nussinussi/Projekt6Thesis/Fachbericht/subsections/Server.tex

\subsection{Server}\label{subsec: Server}
Als Server für die Openhab Software wird ein Raspberry Pi der 4. Generation mit 2 GB RAM eingesetzt, die Installation und Inbetriebnahme wird im Benutzerhandbuch beschrieben. In Openhab wird ebenfalls ein eigener MQTT-Broker eingebunden. Damit diese Broker von jedem Gerät im Lokalen Netzwerk erreicht werden kann, wird dem Server eine Statische IP-Adresse vergeben.\\
\\
Um den Sprachassistent einzubinden,ist ein weiterer Server mit der Home Assistant Software in das System integriert worden. Dieser Server wurde auf ein Rasperrypi 4. Generation 2 GB RAM installiert. Der Grund warum nicht beide Server auf dem selben Raspberrypi installiert wurden, ist einerseits, das System ist physikalisch Modular aufgebaut der Sprach Assistent kann als separates Thing (Gerät) betrachtet werden. Andererseits, wenn sich beide Server auf dem Selben Gerät befinden wäre die MQTT-Kommunikation sinnlos.  

\begin{figure}[H]
	\centering
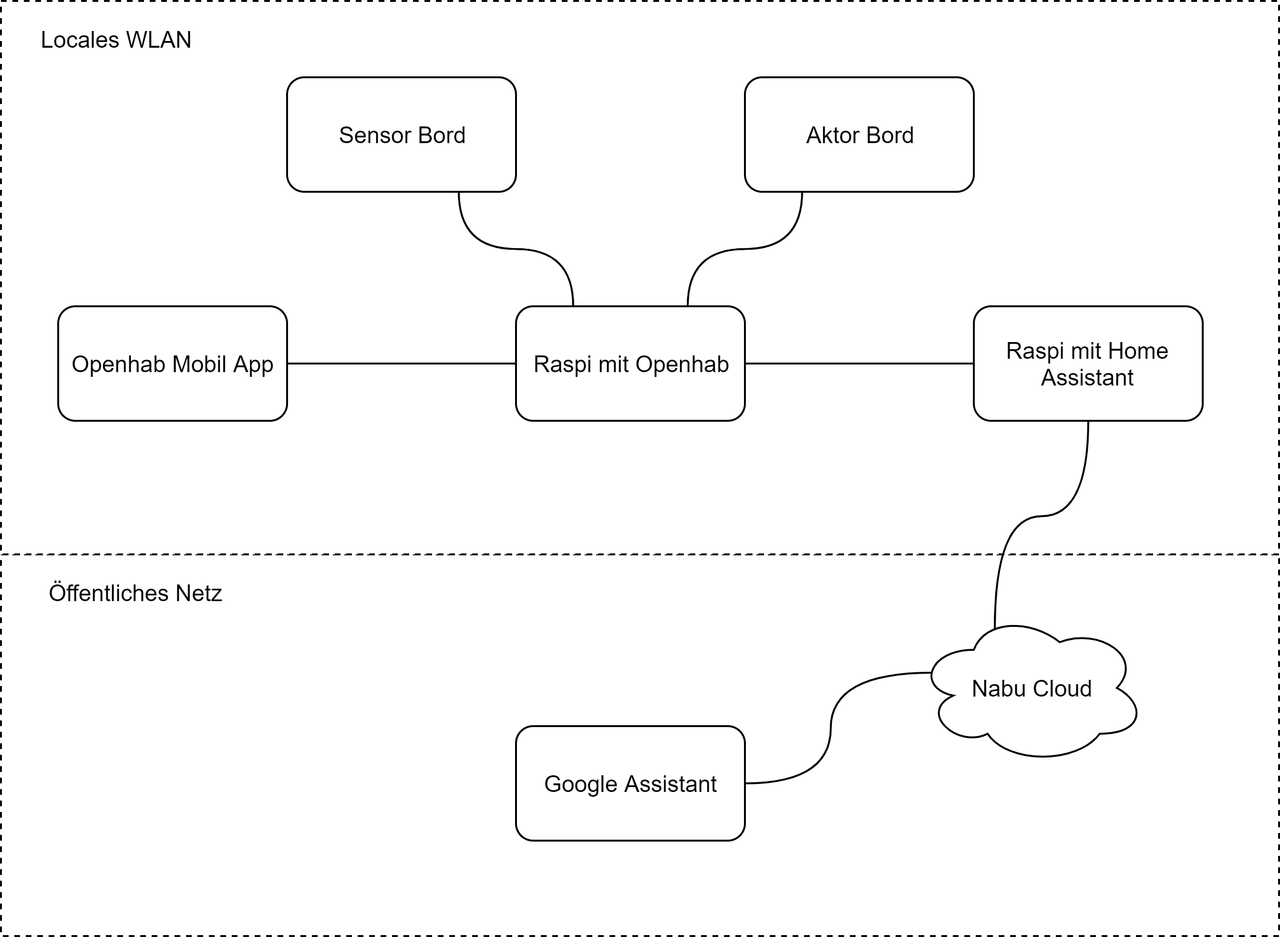
[picture p45: Fachbericht/graphics/Systemubersicht.png]
	
	\caption{Systemübersicht}
	\label{pic: Systemübersicht}
\end{figure}   

In der Abbildung \ref{pic: Systemübersicht} kann erkannt werden, dass sich beide Server im selben Lokalen Netzwerk befinden. Die Kommunikation zwischen den beiden Server findet über MQTT statt, es besteht die Möglichkeit den Openhab-Server zu umgehen und eine direkte Kommunikation vom Home Assistant zu dem Sensor- oder zum Aktorbord zu realisieren. In diesem Fall müssen aber die Regeln bei welchem Aktion, welche Schalthandlung ausgelösst wird, in den entsprechenden Mikrocontroller programmiert werden.

\subsection{Sprachassistent}
Der Home Assistant wird als Brücke für den Google Assistant installiert. Mit der Home Assistant Cloud wird eine Verbindung zum Google Assistant hergestellt. Der Grund, warum die Verbindung so aufgebaut wird, liegt darin, dass die dynamische DNS Adresse, SSL-Zertifikate und das öffnen von Ports auf dem Router so umgangen werden. Leider ist die Cloud nach einer Testphase kostenpflichtig. Wird die Lösung ohne Cloud bevorzugt, kann nach Anleitung \cite{assistant_google_nodate} gearbeitet werden. Die Cloud ist im /config/configuration.yaml file schon vorinstalliert. Im Webinterface vom Home Assistant kann in den Einstellungen ein Benutzerkonto angelegt werden und schon ist die Cloud aktiv. Das hinzufügen von Schalter um MQTT-Befehle zu generieren wird im Benutzerhandbuch im Anhang beschrieben. Die Installation auf dem Google-Nest (Monitor von Google) wird mit einem Smartphone durchgeführt. Mittels Google Home App kann das Gerät 'Home Assistant' hinzugefügt werden.
\begin{figure}[H]
	\centering
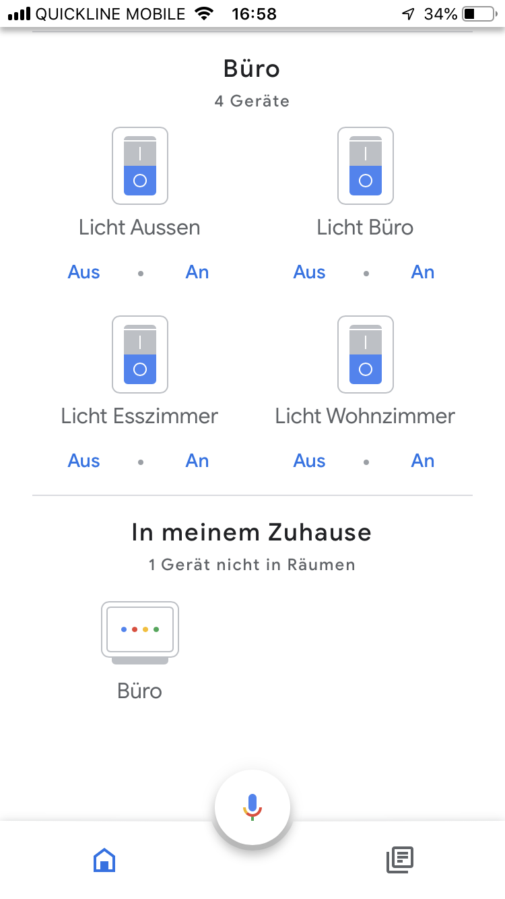
[picture p46: Fachbericht/graphics/GoogleAssistant.png]
	
	\caption{Google Assistant Mobile-App}
	\label{pic: GoogleAssistant}
\end{figure}   
In der Abbildung \ref{pic: GoogleAssistant} können die Schalter, welche Home Assistant definiert wurden erkannt werden. Sie können mit Sprachbefehl geschalten werden, falls die Schalter-Bezeichnung und der Zustand genannt wird, wie beispielsweise "Licht-Büro-ein". Die verschiedenen Geräte können, nebst dem Sprachbefehl in dieser Ansicht, mit einem Touch-Befehl geschallten werden.
