nussinussi/Projekt6Thesis/Fachbericht/sections/Software.tex

\section{Software}
In diesem Kapitel wird der Softwarebereich beschrieben. Es wird erklärt, wie die Frameworks der Mikrocontroller, welche auf den Sensor und Aktorbausteinen laufen, evaluiert wurden. Zusätzlich wird die Realisierung des Frameworks für den inhouse Server und die Kommunikation mit dem MQTT Protokoll aufgezeigt.

\input{subsections/Mikrocontroller}
\input{subsections/Framework}
\input{subsections/Kommunikation}
\input{subsections/Server}
