nussinussi/Projekt6Thesis/Fachbericht/sections/Ehrlichkeitserklaerung.tex

\section{Ehrlichkeitserklärung}

Hiermit erklären wir, dass die vorliegende Arbeit selbständig von uns, ohne Hilfe Dritter und nur unter Benutzung der angegebenen Quellen verfasst wurde.\\
\\
\\
\\
\\
\\
\\

	\begin{tabular}{l l}
	\textbf{Projekt Team} \\
	\\
	\\
	Lukas Meienberger und Gabriel Nussbaumer \\ 
	\\
	\\
		\rule{44mm}{.15mm} & \hspace{1mm} \rule{70mm}{.15mm} \\
	Ort, Datum & \hspace{1mm} Unterschriften \\
	
\end{tabular}\\
