nussinussi/Projekt6Thesis/Fachbericht/sections/Hardware.tex

\section{Hardware}
 
\input{subsections/Sensorbaustein}
 \newpage
\input{subsections/Aktorbaustein}
