nussinussi/Projekt6Thesis/Poster/Template_Poster_Thesis_V2019_EIT.pptx

Ausstellungs-Nr. Enn

Studiengang / Semester: Elektro – und Informationstechnik FS19
Diplomandin: Petra Muster
Auftraggeber: Experimental Sample AG
Experte: Paul Müller, dipl. Ing. ETH
Dozent : Prof. Dr. Emil Dreher, emil.dreher@fhnw.ch
