nussinussi/Projekt6Thesis/Benutzerhanbuch/Latex Benutzerhanbuch/Benutzerhandbuch/versions/1.0_Regelauslegung.pdf

# Geberloser drehzahlvariabler Drehfehlmaschinen-Antrieb

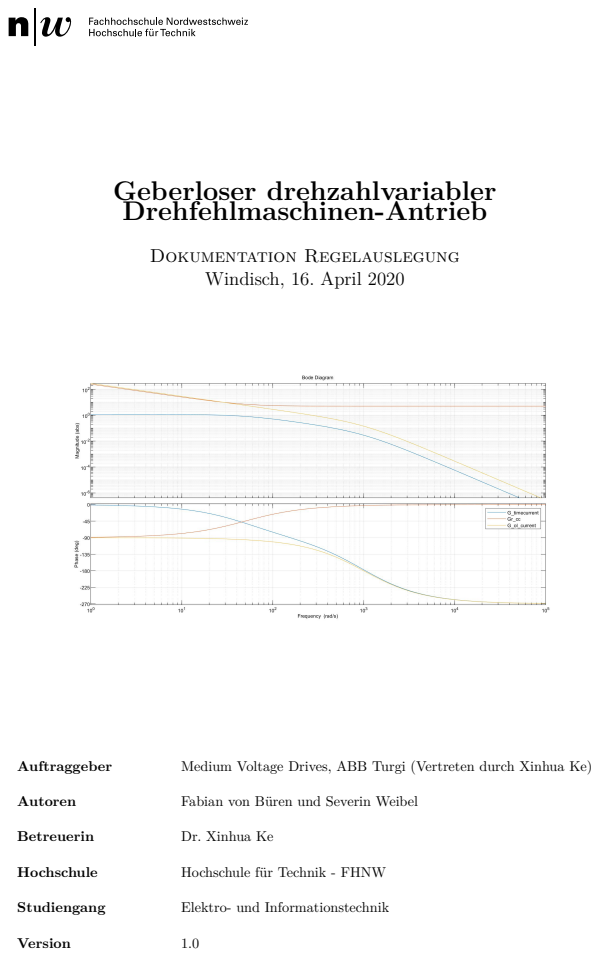
[picture p79: page 1]
Dokumentation Regelauslegung Windisch, 16. April 2020; Auftraggeber; Medium Voltage Drives, ABB Turgi (Vertreten durch Xinhua Ke); Autoren; Fabian von Büren und Severin Weibel; Betreuerin; Dr. Xinhua Ke; Hochschule; Hochschule für Technik - FHNW; Studiengang; Elektro- und Informationstechnik; Version

INHALTSVERZEICHNIS | I

### Inhaltsverzeichnis

1 Dokumentation der Regelauslegung | 1
2 Simulationsresultat | 11
3 Offene Pendenzen | 12
4 Literatur | 14
A Messungen Zeitverzögerung Modulator | 15

1

### 1 Dokumentation der Regelauslegung

Durchgeführt von: Fabian von Büren & Severin Weibel

Datum: 16. April 2020

Diese Dokumentation beschreibt das Vorgehen der Regelauslegung. Die rotorflussorientierte Drehzahlregelung umfasst insgesamt drei Regelkreise. Bei jedem Regelkreis wird ein PI-Regler verwendet. Das Ziel ist die Bestimmung der Proportionalverstärkung (kp) sowie die Integralverstärkung (ki). Begonnen wird mit dem unterlagertem Stromregelkreis. Die mathematische Beschreibung der ASM basiert auf dem Skript „Geregelte Antriebe“ [1]. Es wird ein linearer Regler ausgelegt.

### 1.1 Maschinenparameter

Folgende Maschine wird verwendet:

Hersteller | Siemens
Maschinentyp | Käfigläufer ASM
Maschinennummer | 1LE1001-1CB03-4AA4
Nennspannung UN (50Hz, 60Hz) | ∆400V, ∆460V
Nennstrom IN (50Hz, 60Hz) | 11.3A, 9.9A
Nennleistung PN | 5.5kW
cosϕ | 0.8
Nenndrehzahl ωn(50Hz) | 1465U/min

Tabelle 1.1: Nenndaten für die auszumessende ASM-Maschine

Folgende Maschinenparameter werden verwendet (ASM im Labor ausgemessen):

Rotorwiderstand RS | 2.6/3Ω
Hauptinduktivität Lh | 359.9/3mH
Streuinduktivität Stator Lσ,S | 54.23/2/3mH
Streuinduktivität Rotor Lσ,R | 54.23/2/3mH
Statorwiderstand RR | 2.6/3Ω

Tabelle 1.2: Ergebnisse für die untersuchte ASM-Maschine (Faktor 3 aufgrund Stern-Dreieck-Umwandlung)

Folgende Variablen werden zur vereinfachten Darstellung verwendet:

1.2 Stromregelkreis (unterlagert) | 2
LS = Lσ,S + Lh | (1.1a)
LR = Lσ,R + Lh | (1.1b)

L

2
σ = LS · LR − Lh
2 | (1.1c)

### 1.2 Stromregelkreis (unterlagert)

In der Abbildung 1.1 ist das Blockschaltbild mit den berücksichtigten Elementen dargestellt. Die Bezeichnungen der Übertragungsfunktionen stimmen mit dem Matlab-File überein. Zur Bestimmung der Regelparameter muss die zu regelnde Strecke identifiziert werden.

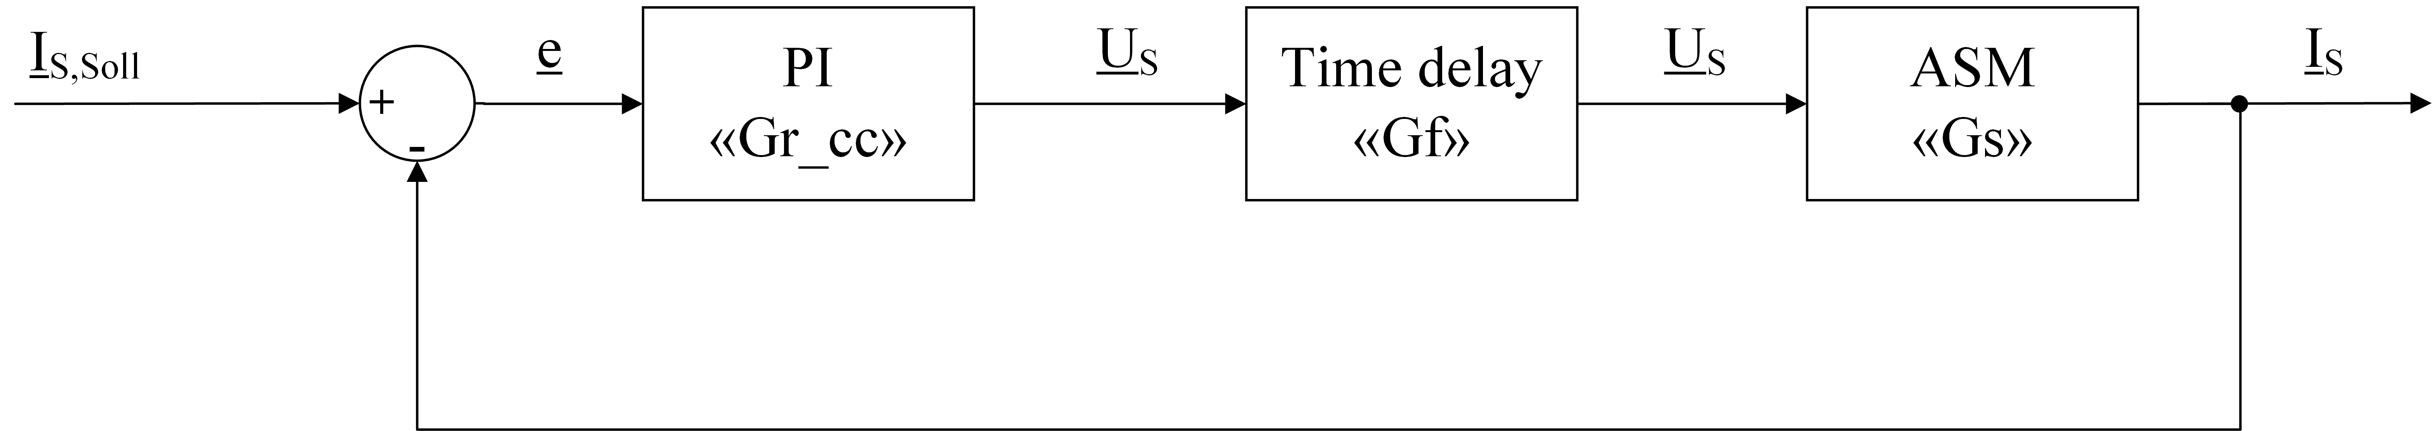
[picture p80: figure]

Abbildung 1.1: Blockdiagramm der unterlagerten Stromregelung

### 1.2.1 ASM - Statorstrom in Funktion von Statorspannung: Gs

Die mathematische Beschreibung der ASM ist in den Gleichungen 1.2 und 1.3 ersichtlich. Für die lineare Reglerauslegung können jedoch Teile der Gleichungen vernachlässigt werden. Die beiden Gleichungen sind untereinander gekoppelt. Da die Entkoppelung am Reglerausgang vollzogen wird, können bei den Gleichungen 1.2 und 1.3 die beiden letzten Terme vernachlässigt werden. Weiter gilt, dass der Rotorflusszeiger auf die x-Achse gelegt wird, daraus folgt |ΨR| = ΨR,x.

uS,x = RS · iS,x +

L

2
σ
LR

·

diS,x
dt − ωK ·

L

2
σ
LR
- iS,y −

Lh
LR
- ωK · ΨR,y | (1.2)

uS,y = RS · iS,y +

L

2
σ
LR

·

diS,y
dt + ωK ·

L

2
σ
LR
- iS,x −

Lh
LR
- ωK · ΨR,x | (1.3)

Dadurch vereinfacht sich die Gleichung in eine Differentialgleichung erster Ordnung.

uS,x = RS · iS,x +

L

2
σ
LR

·

diS,x
dt | (1.4)

uS,y = RS · iS,y +

L

2
σ
LR

·

diS,y
dt | (1.5)

In den Frequenzbereich transformiert folgt die Übertragungsfunktion Gs.

Gs =

IS,x

US,x

=

IS,y

US,y

=

IS
US

=

1
RS
1 + s ·

L²
σ
LR·RS
| (1.6)

1.2 Stromregelkreis (unterlagert) | 3

### 1.2.2 Modulator Zeitverzögerung: Gf

Der Modulator sowie die diskrete Programmbearbeitung werden durch eine Zeitverzögerung berücksichtigt. Die Zeitverzögerung zwischen dem Reglerausgang sowie der modulierten Statorspannung wurde in der Simulation gemessen und beträgt 1ms (siehe Anhang A.1). Die Zeitverzögerung kann als einfacher Tiefpass oder Allpass approximiert werden. In diesem Fall wurde der Allpass durch die Pade-Approximation gebildet. Die Pade-Approximation ist auf den Winkel ϕ = 120° angepasst.

td = 1ms | (1.7)

ϕ = 120◦
(1.8)

T = tan

ϕ
2
·

td
ϕ

(1.9)

Daraus ergibt sich die Übertragungsfunktion Gf:

Gf =

1 − s · T
1 + s · T

(1.10)

### 1.2.3 Identifizierte Strecke: G_timecurrent

Wie in Abbildung 1.1 zu sehen, können die beiden Übertragungsfunktionen Gf und Gs zusammengefasst werden.

G_timecurrent = Gs · Gf | (1.11)

Anhand dieser Übertragungsfunktion wird nun der PI-Regler ausgelegt.

### 1.2.4 Stromregler Gr_cc

Der offene Regelkreis (ohne Regler) ist F0 (jω) = Gs · Gf = G_timecurrent und ist somit die zu regelnde Strecke. Die Strecke hat einen stationären Endwert, so müssen die Bode Sätze 1, 2 und 3 erfüllt sein. (Anleitung gemäss [2, S. 45]). Die Übertragungsfunktionen sind im Bodeplot 1.2 abgebildet.

1. Die Eckfrequenz beträgt 1
TN

=

LR·RS
L²
σ

. Die Integralverstärkung des Reglers ist somit

ki_cc =

1
TN

=

LR·RS
L²
σ
2. Die Proportionalverstärkung kp_cc beträgt 5.75. Somit ist die Verstärkung des Amplitudengangs bei ωD = 330rad
s

Eins.

1.2 Stromregelkreis (unterlagert) | 4

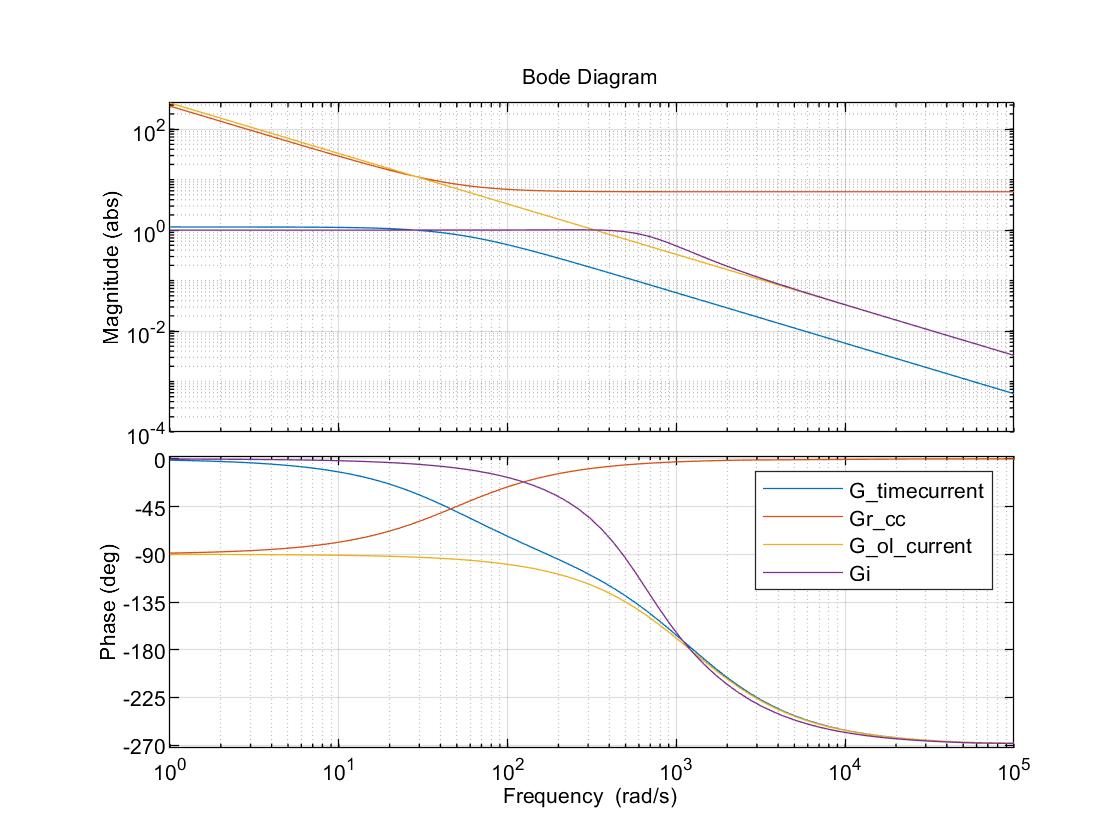
[picture p81: figure]

Abbildung 1.2: Bodediagramm der zu regelnde Strecke G_timecurrent

In Abbildung 1.3 ist die offene Regelstrecke G_ol_current = Gr_cc · G_timecurrent im Bodeplot abgebildet. Bei kp_cc = 5.75 und ki_cc = LR·RS
L²
σ

= 49.7 beträgt die Phasenreserve 59.5 deg und die Amplitudenreserve 11.3 dB.

1.3 Rotorfluss-Regelkreis | 5

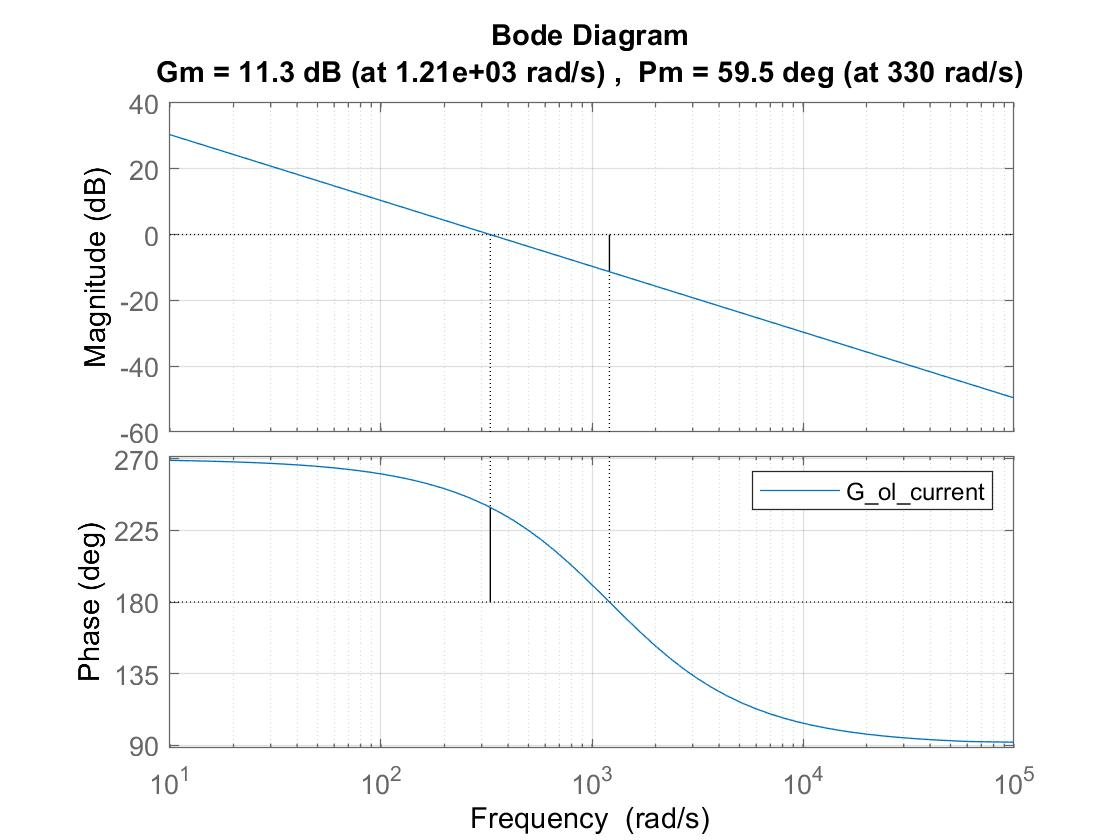
[picture p82: figure]

Abbildung 1.3: Bodediagramm des offenen Strom-Regelkreises

### 1.2.5 Geschlossener Stromregel-Kreis: Gi

Da es sich um eine Kaskaden-Regelung handelt, muss der offene Reglerkreis in einen geschlossenen Regelkreis gewandelt werden.

Gi =

G_ol_current
1 + G_ol_current

(1.12)

In Matlab kann diese Rechnung mit dem Befehl Gi = feedback(G_ol_current,1) durchgeführt werden. Der geschlossene Regelkreis beträgt somit:

Gi =

−0.0001104s

2 + 0.128s + 6.635
3.35e − 07s

3 + 0.0003113s

2 + 0.1482s + 6.635

(1.13)

Diese Übertragungsfunktion ist auch in Abbildung 1.2 abgebildet. Die Übertragungsfunktion Gi wird in den überlagerten Regelkreisen verwendet.

### 1.3 Rotorfluss-Regelkreis

Nun folgt der Rotorfluss-Regler. Dieser Regelkreis ermittelt den Sollstrom iS,x,Soll. In der Abbildung 1.4 ist das Blockschaltbild mit den berücksichtigten Elementen dargestellt. Die Bezeich-

1.3 Rotorfluss-Regelkreis | 6

nungen der Übertragungsfunktionen stimmen mit dem Matlab-File überein. Zur Bestimmung der Regelparameter muss die zu regelnde Strecke identifiziert werden.

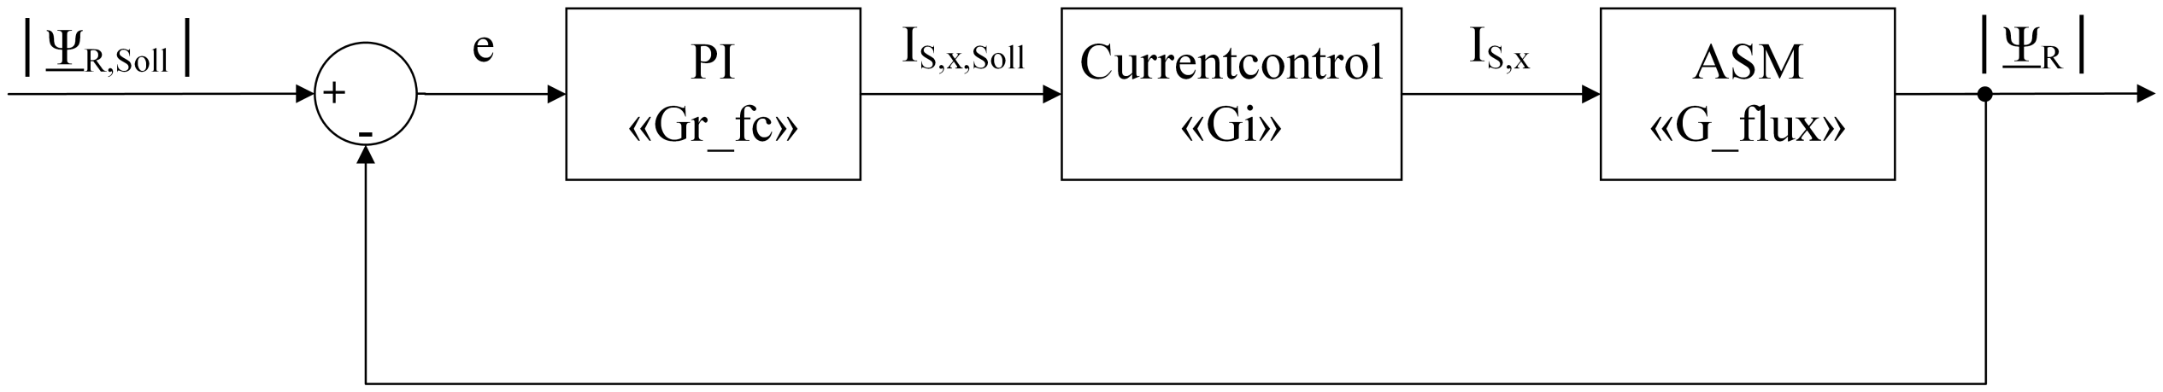
[picture p83: figure]

Abbildung 1.4: Blockdiagramm der Rotorfluss-Regelung

### 1.3.1 ASM - Rotorfluss in Funktion von Statorstrom: G_flux

Die mathematische Beschreibung der ASM ist in den Gleichung 1.14 ersichtlich. Weiter gilt, dass der Rotorflusszeiger auf die x-Achse gelegt wird, daraus folgt |ΨR| = ΨR,x. Die Gleichung ist eine Differentialgleichung erster Ordnung.

iS,x = ΨR,x ·

1
Lh

+

τR
Lh

·

dΨR,x
dt | (1.14)

τR =

LR
RR

(1.15)

In den Frequenzbereich transformiert folgt die Übertragungsfunktion G_flux.

G_flux =

ΨR,x

IS,x

=

Lh
1 + s · τR

(1.16)

### 1.3.2 Identifizierte Strecke: G_fluxcurrent

Wie in Abbildung 1.4 zu sehen, können die beiden Übertragungsfunktionen Gi und G_flux zusammengefasst werden.

G_fluxcurrent = Gi · G_flux | (1.17)

Anhand dieser Übertragungsfunktion wird nun der PI-Regler ausgelegt.

### 1.3.3 Flussregler Gr_fc

Der offene Regelkreis (ohne Regler) ist F0 (jω) = Gi · G_flux = G_fluxcurrent und ist somit die zu regelnde Strecke. Die Strecke hat einen stationären Endwert, so müssen die Bode Sätze 1, 2 und 3 erfüllt sein. (Anleitung gemäss [2, S. 45]). Die Übertragungsfunktionen sind im Bodeplot 1.5 abgebildet.

1. Die Eckfrequenz beträgt 1
τR

=

RR
LR

. Die Integralverstärkung des Reglers ist somit ki_f c =

1
τR

=

RR
LR
2. Die Proportionalverstärkung kp_fc beträgt 222.22. Somit ist die Verstärkung des Amplitudengangs bei ωD = 181rad
s

Eins.

1.3 Rotorfluss-Regelkreis | 7

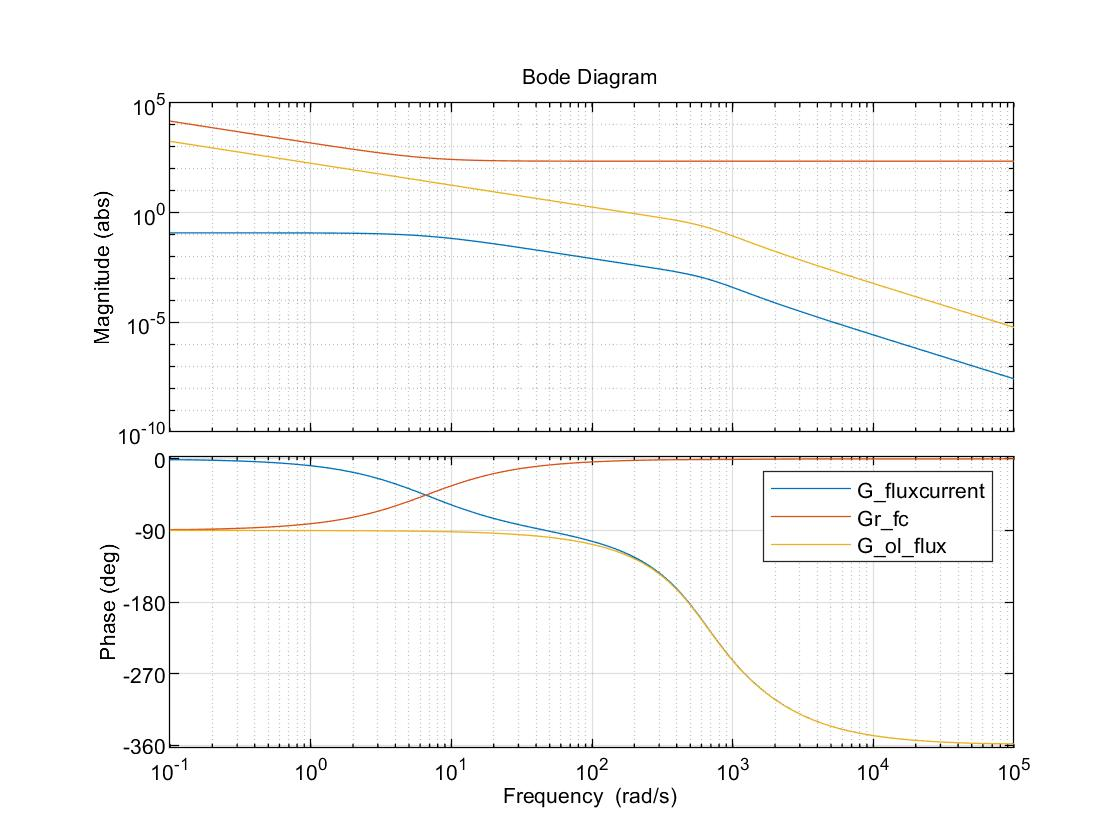
[picture p84: figure]

Abbildung 1.5: Bodediagramm der zu regelnde Strecke G_fluxcurrent

In Abbildung 1.6 ist die offene Regelstrecke G_ol_flux = Gr_f c·G_fluxcurrent im Bodeplot abgebildet. Bei kp_fc = 222.22 und ki_fc = RR
LR

= 6.72 beträgt die Phasenreserve 58 deg und die Amplitudenreserve 9.07 dB.

1.4 Drehzahl-Regelkreis | 8

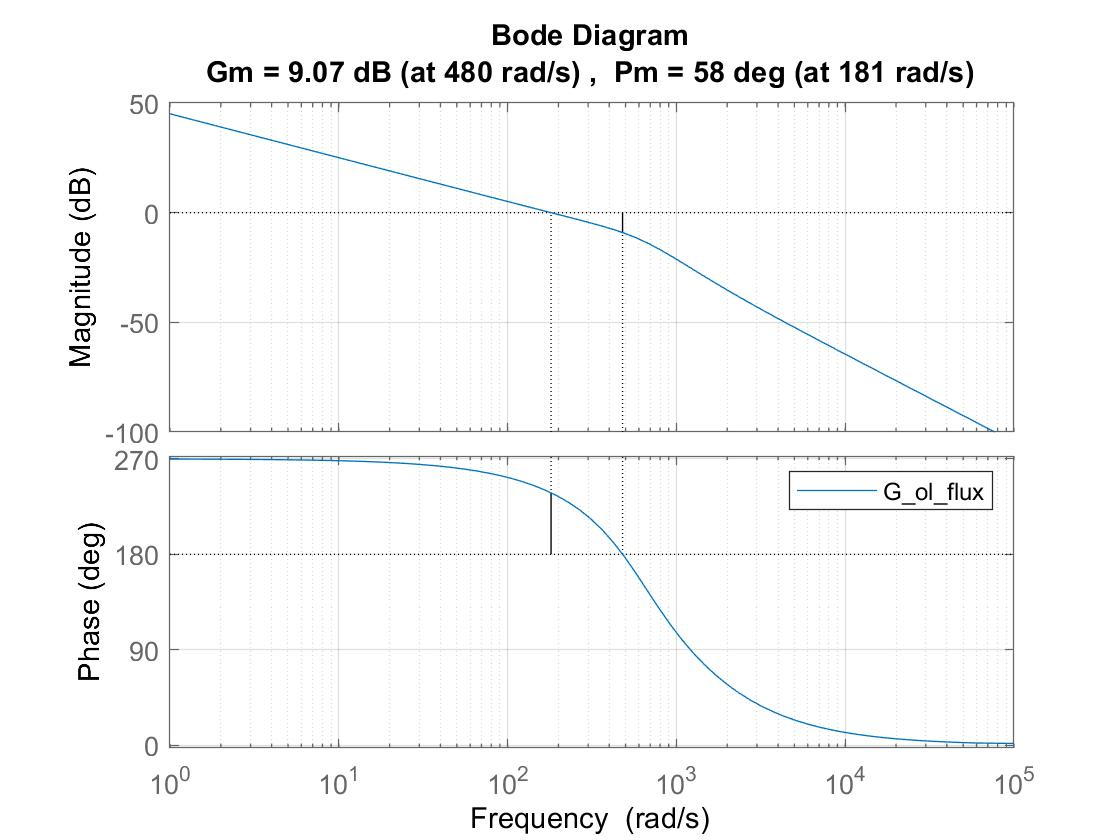
[picture p85: figure]

Abbildung 1.6: Bodediagramm des offenen Rotorfluss-Regelkreises

### 1.4 Drehzahl-Regelkreis

Nun folgt der Drehzahl-Regler. Dieser Regelkreis ermittelt den Sollstrom iS,y,Soll. In der Abbildung 1.7 ist das Blockschaltbild mit den berücksichtigten Elementen dargestellt. Die Bezeichnungen der Übertragungsfunktionen stimmen mit dem Matlab-File überein. Zur Bestimmung der Regelparameter muss die zu regelnde Strecke identifiziert werden.

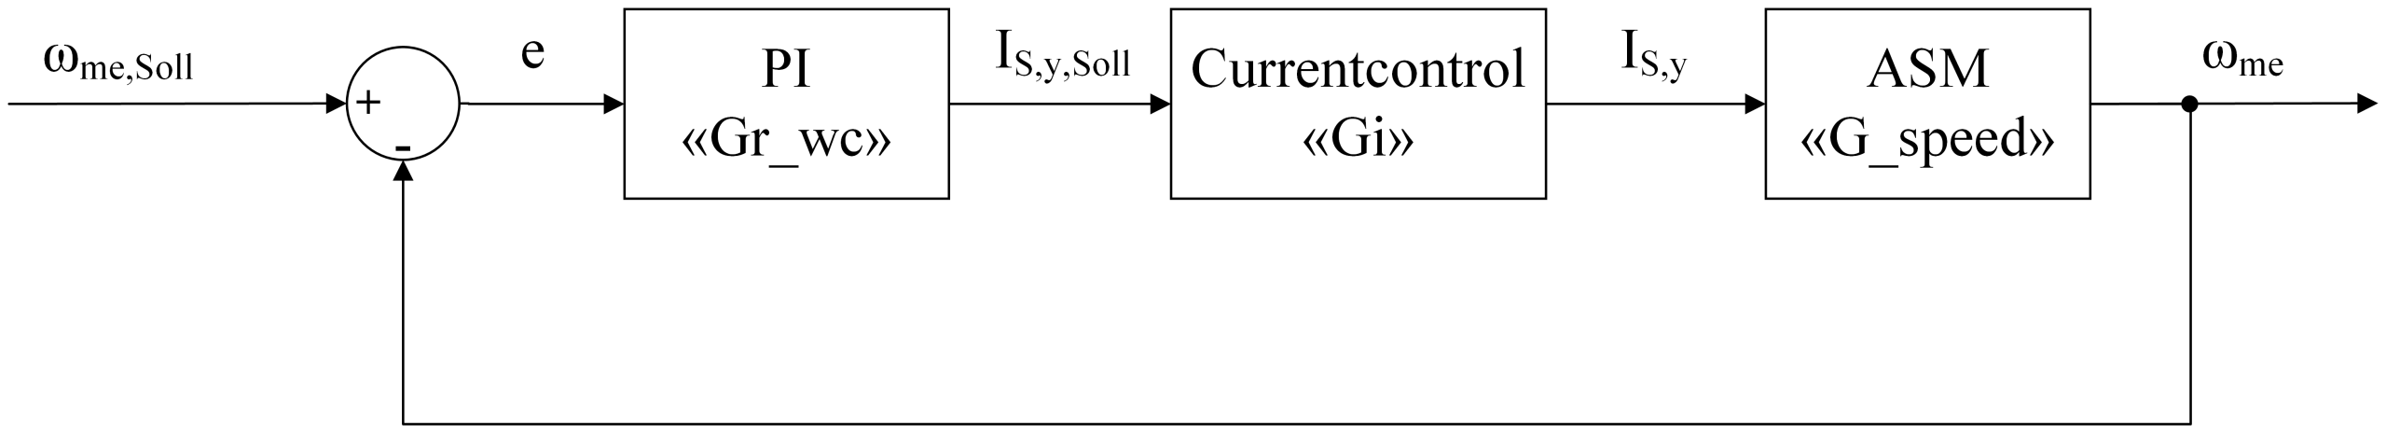
[picture p86: figure]

Abbildung 1.7: Blockdiagramm der Drehzahl-Regelung

### 1.4.1 ASM - Drehzahl in Funktion von Statorstrom: G_speed

Die mathematische Beschreibung der ASM im Frequenzbereich ist in den Gleichung 1.21 ersichtlich. Im Gegensatz zu den vorherigen Strecken mit stationärem Endwert hat diese zu regelnde Strecke eine Integral-Charakteristik. Das führt zu einem unterschiedlichem Vorgehen bei der linearen Reglerauslegung. Die Beziehung zwischen Drehzahl und Statorstrom (y-Komponente)

1.4 Drehzahl-Regelkreis | 9

wird mit einem Zwischenschritt über das elektrische Moment gemacht (Gleichung 1.18). Die Polpaarzahl p beträgt zwei und das Trägheitsmoment der Maschine (gekoppelt mit einer DCM) wird mit 0.088kgm² angenommen.

Mel =

|ΨR,x|
k
- iS,y | (1.18)

k =

2 · LR
3 · p · Lh

(1.19)

Durch Integration des Moments kann auf die Drehzahl ωme zurückgeschlossen werden (Gleichung ??). Für die lineare Reglerauslegung beträgt das Lastmoment MLoad = 0.

ωme =

1

Jtot

·

Z
(Mel − MLoad) dt | (1.20)

Diese physikalischen Beziehungen zusammengefasst und in den Frequenzbereich transformiert ergibt die Übertragungsfunktion G_speed.

G_speed =

ωme

iS,y

=

1
s

·

|ΨR|
J · k

(1.21)

### 1.4.2 Identifizierte Strecke: G_speedcurrent

Wie in Abbildung 1.7 zu sehen, können die beiden Übertragungsfunktionen Gi und G_speed zusammengefasst werden.

G_speedcurrent = Gi · G_speed | (1.22)

Anhand dieser Übertragungsfunktion wird nun der PI-Regler ausgelegt.

### 1.4.3 Drehzahlregler Gr_wc

Der offene Regelkreis (ohne Regler) ist F0 (jω) = Gi · G_speed = G_speedcurrent und ist somit die zu regelnde Strecke. Die Strecke hat keinen stationären Endwert, sondern eine Integral-Charakteristik. So muss der Bode Satz 4 erfüllt sein. (Anleitung gemäss [2, S. 45]). Die Übertragungsfunktionen sind im Bodeplot 1.8 abgebildet.

1. Die Frequenz ω1 (Übergang von -1 D/D auf -2 D/D) liegt bei 330rad
s
2. Die Eckfrequenz des PI-Reglers wird auf ω1/10 gelegt = 33rad
s

. Somit beträgt die Integralverstärkung ki_wc = 33.
3. Die Proportionalverstärkung kp_fc beträgt 3.77. Somit ist die Verstärkung des Amplitudengangs bei in der Mitte des -1 D/D-Stück Eins.

1.4 Drehzahl-Regelkreis | 10

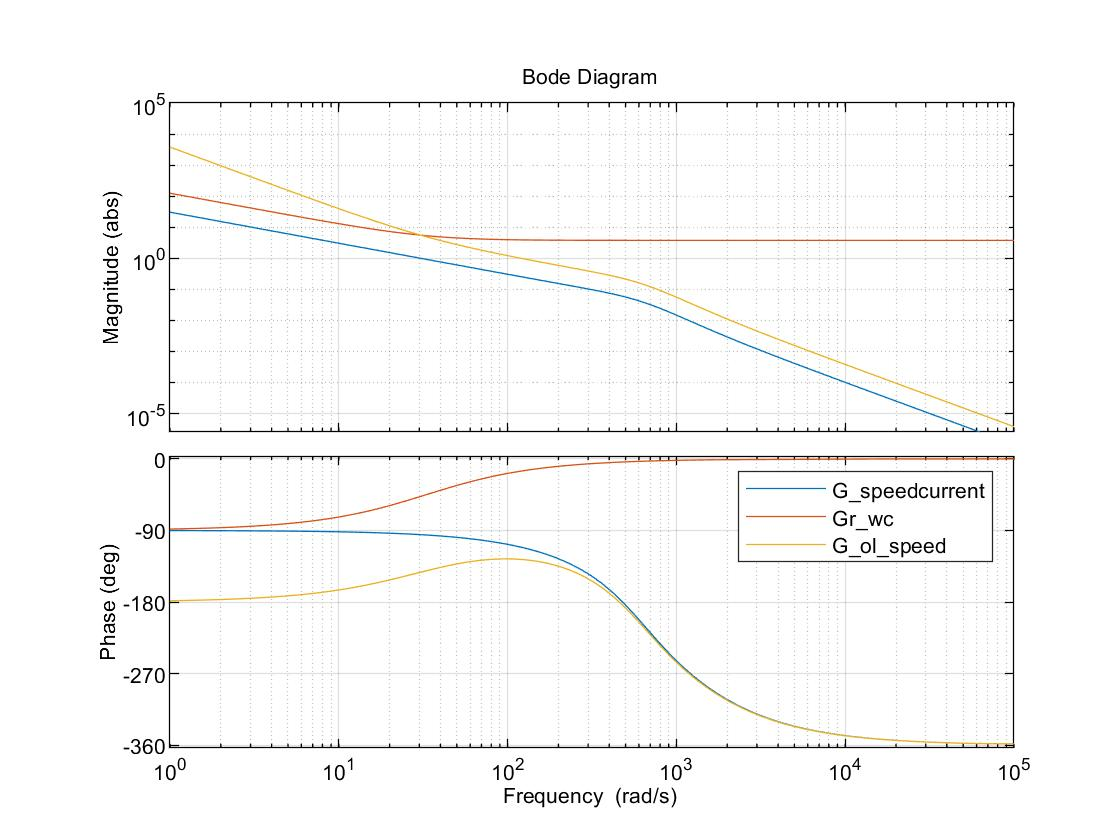
[picture p87: figure]

Abbildung 1.8: Bodediagramm der zu regelnde Strecke G_speedcurrent

In Abbildung 1.9 ist die offene Regelstrecke G_ol_speed = Gr_f c · G_speedcurrent im Bodeplot abgebildet. Bei kp_wc = 3.77 und ki_wc = 33 beträgt die Phasenreserve 53.6 deg und die Amplitudenreserve 12.4 dB.

11

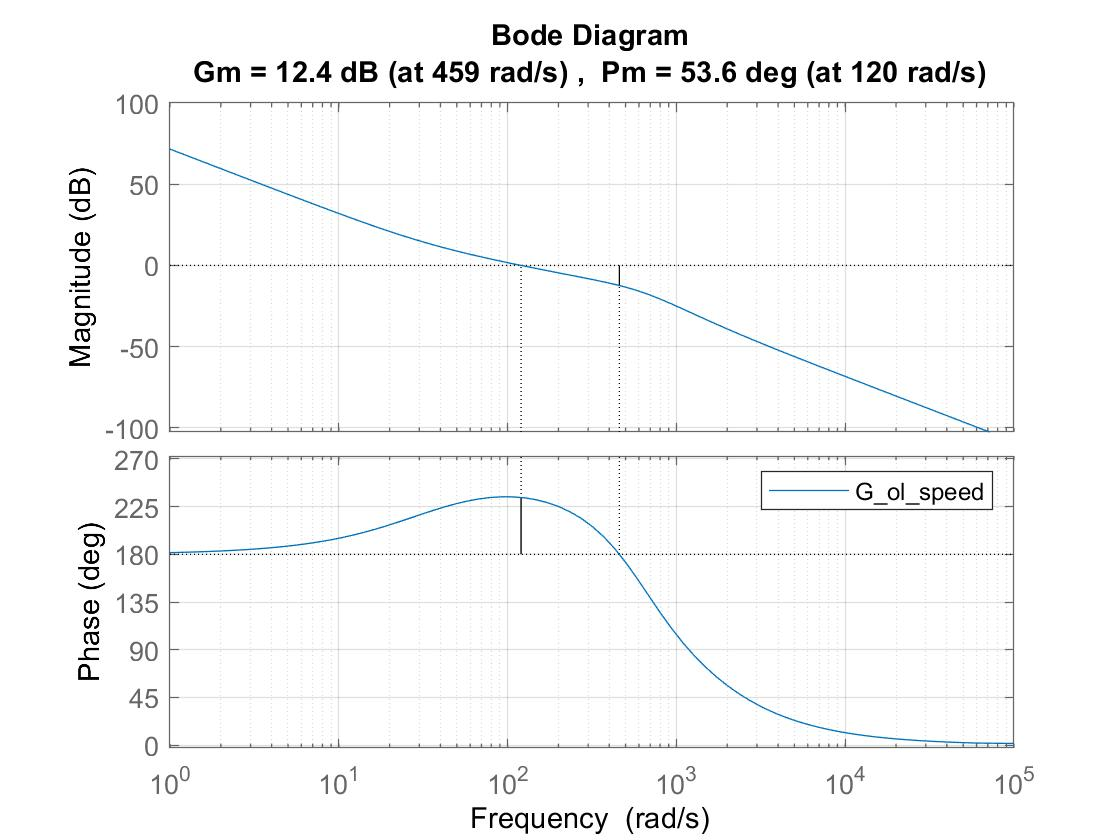
[picture p88: figure]

Abbildung 1.9: Bodediagramm des offenen Drehzahl-Regelkreises

### 2 Simulationsresultat

Die ermittelten Regler-Parameter wurden in Simulink simuliert. Die Resultate sind in den Abbildungen 2.1 und 2.2 zu sehen. Abschliessend kann ausgesagt werden, dass das zu regelnde System beim Anlauf auf Nenndrehzahl stabil ist. Jedoch kann die Performance weiter verbessert werden. Die ausgelegten Regelparameter dienen dazu als Basis.

Parameter: | Wert:
kp_cc | 5.75
ki_cc | LR·RS = 49.7 L² σ
kp_fc | 222.22
ki_fc | RR = 6.72 LR
kp_wc | 3.77
ki_wc | 33

Tabelle 2.1: Die Auflistung der verwendeten Parameter in der Regelung

12

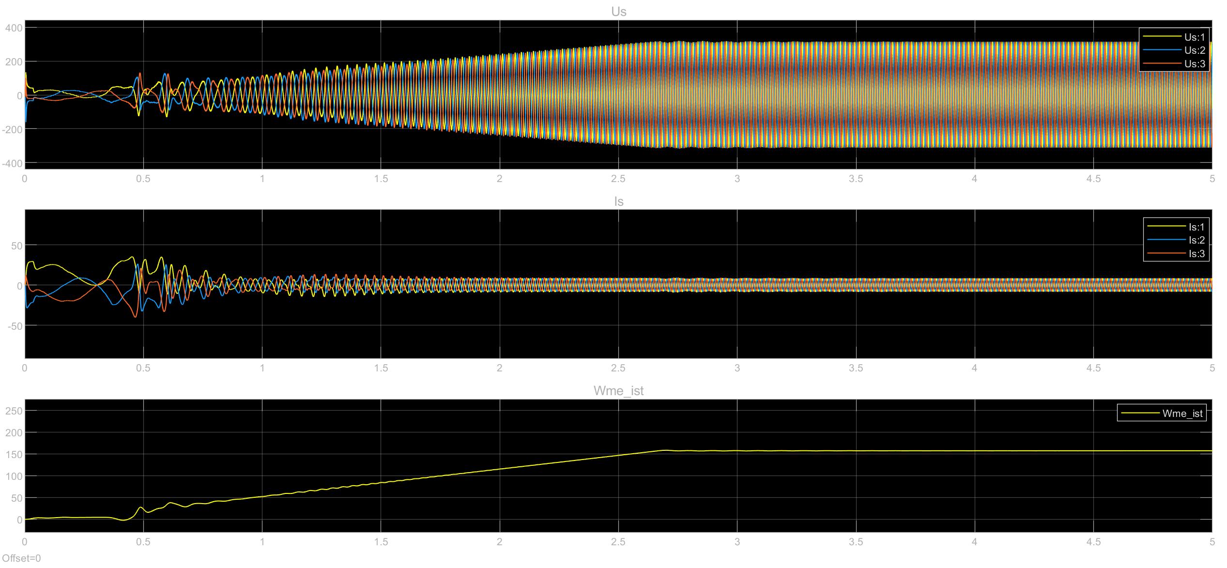
[picture p89: figure]

Abbildung 2.1: Simulationsresultat mit Statorstrom, Statorspannung und Drehzahl der ASM

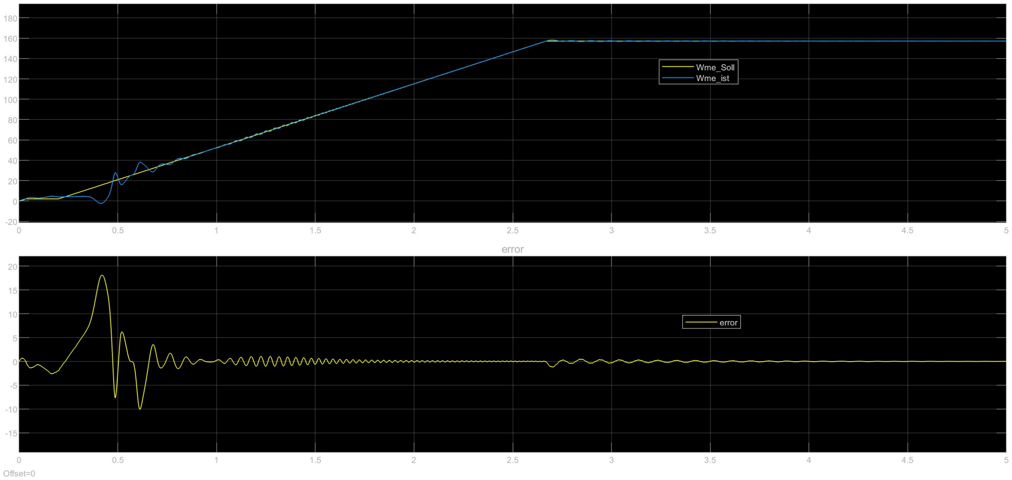
[picture p90: figure]

Abbildung 2.2: Simulationsresultat des Drehzahlreglers

### 3 Offene Pendenzen

In dieser linearen Reglerauslegung wurden einigen Vereinfachungen angenommen und Elemente nicht berücksichtigt. Folgend werden die offenen Punkte aufgelistet. Bei einer genaueren Analyse können diese berücksichtigt werden.

- Der Flussrechner wurde nicht berücksichtigt. Für ein stabiles System muss der Flussrechner auch stabil sein. In einem weiteren Schritt kann dies analysiert werden.
- Es wurden keine Filter berücksichtigt, die in der Simulation vorhanden sind.
- Die Programmbearbeitung läuft diskret und nicht zeit-kontinuierlich. Dies wurde nur bei der Zeitverzögerung im Stromregelkreis näherungsweise berücksichtigt.

13

- Der Modulator wurde in der obigen Auslegung in der Zeitverzögerung „mitberücksichtigt“. (siehe Anhang A.1)
- Die Performance der Drehzahlregelung ist nicht optimal, vor allem beim Start der Solldrehzahl-Erhöhung treten grosse Abweichungen auf (siehe Abbildung 2.2).
- Während dem Tunen wurde ein besseres Resultat erzielt. Dabei wurden folgende Parameter verwendet: kp_cc = 50.75 und kp_fc = 22.22. Das Resultat ist in Abbildung 3.1 ersichtlich.

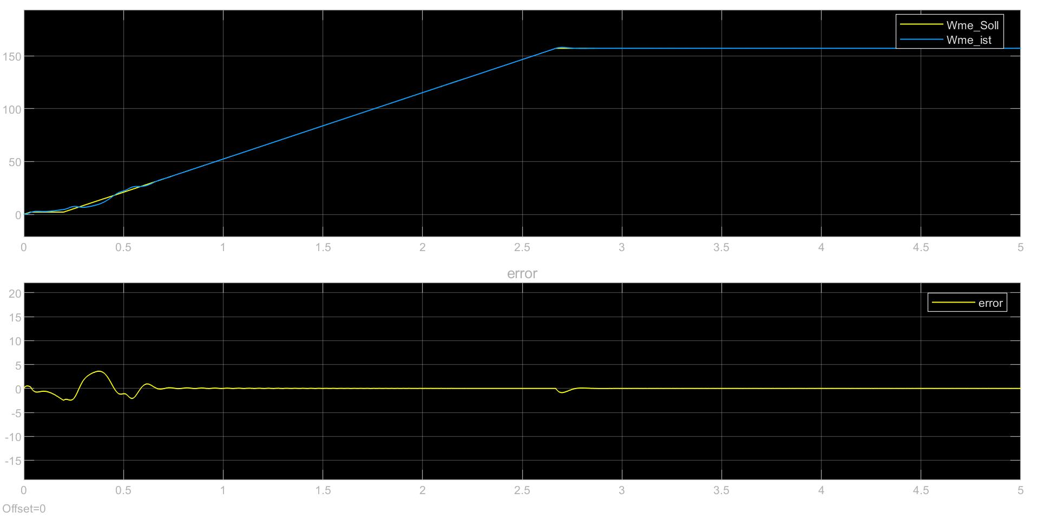
[picture p91: figure]

Abbildung 3.1: Simulationsresultat des Drehzahlreglers während Tunen

14

### 4 Literatur

[1] Felix Jenni und Xinhua Ke, „Geregelte antriebe mit drehfeldmaschinen und selbstgeführten stromrichtern“, Unpubliziertes Dokument, Windisch: Fachhochschule Nordwestschweiz (FHNW), 2019. (Abrufdatum 6. Aug. 2019).
[2] Xinhua Ke, „Lineare regelungen: Systemdarstellungen und auslegung von reglern“, Unpubliziertes Dokument, Windisch: Fachhochschule Nordwestschweiz (FHNW), 2019. (Abrufdatum 6. Feb. 2019).

15

### A Messungen Zeitverzögerung Modulator

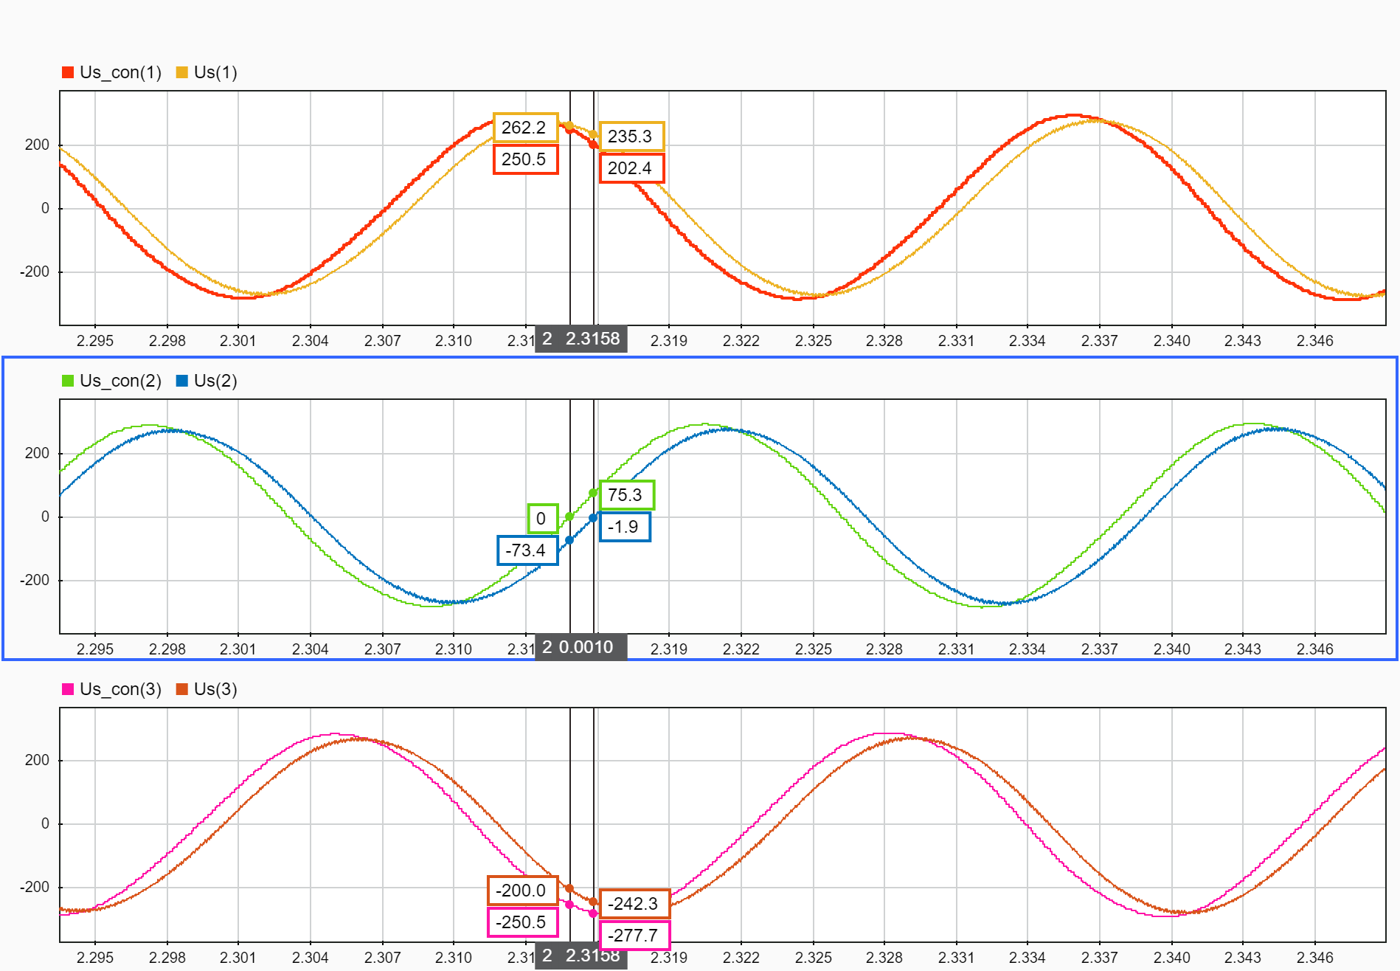
[picture p92: figure]

Abbildung A.1: Messung der Zeitverzögerung zwischen Modulatoreingang und modulierter Spannung an der ASM
