nussinussi/Projekt6Thesis/Benutzerhanbuch/Latex Benutzerhanbuch/Benutzerhandbuch/ReadMe.txt

Gitignore dient dazu die unnützlichen Dateien welche von Latex erstellt werden zu vernachlässigen.
