nussinussi/Projekt6Thesis/Fachbericht/Fachbericht_Projekt_6.tex

% !TeX encoding = UTF-8
\documentclass[final]{fhnwreport}         %[mode] = draft or final
\input{fhnwheader}                        %loads all packages, definitions and settings	
											
\title{Fachbericht}  %Project Title
\author{Integrierte IOT-Raumautomation mit MQTT-Prototokoll}                      %Document Type => Technical Report, ...
\date{Windisch, 14.08.2020}               %Place and Date

\begin{document}

%%---TITLEPAGE---------------------------------------------------------------------------
\selectlanguage{ngerman}                  %ngerman or english
\maketitle

\vspace*{-1cm}
\vfill
\begin{figure}[H]
\centering
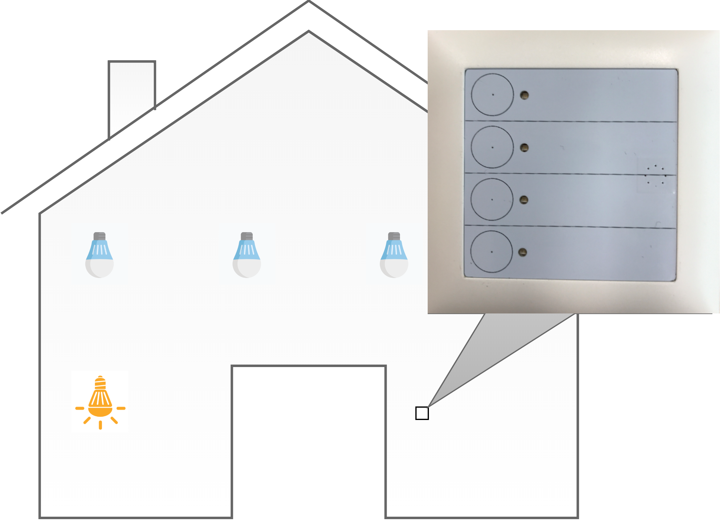
[picture p93: Fachbericht/graphics/titelbild.png]

\end{figure}
\vfill

\begin{center}
\renewcommand\arraystretch{2}
\begin{tabular}{>{\bf}p{6cm} l}
Hochschule                 &    Hochschule für Technik - FHNW\\
Studiengang                &    Elektro- und Informationstechnik\\
Autoren   		                 & 	 Lukas Meienberger und Gabriel Nussbaumer\\
Betreuer und Auftraggeber     &     Albert Zihlmann\\
Experte               &   Remy Bringold \\
Version                    &    1.0 %(Normally not used!)
\end{tabular}
\end{center}

\clearpage
			
%%---ABSTRACT----------------------------------------------------------------------------
\selectlanguage{english}				%ngerman or english
\thispagestyle{empty}
\include{sections/abstract}

%%---TABLE OF CONTENTS-------------------------------------------------------------------
\pagenumbering{Roman}		
\selectlanguage{ngerman}				%ngerman or english
\tableofcontents
\clearpage

%%---TEXT--------------------------------------------------------------------------------
\pagenumbering{arabic}
\include{sections/Einleitung}%EXAMPLE
\include{sections/Gesamtuebersicht}
\include{sections/Theorie}
\include{sections/Openhab}
\include{sections/Software}
\include{sections/Hardware}
\include{sections/Validierung}
\include{sections/Lizenzen}
\include{sections/Verbesserungen}
\include{sections/Schluss}
\include{sections/Ehrlichkeitserklaerung}

%%---BIBLIOGRAPHY------------------------------------------------------------------------
{\sloppypar
\printbibliography[heading=bibintoc]
}

%%---APPENDIX----------------------------------------------------------------------------
\include{sections/appendix}

%%---NOTES for DEBUG---------------------------------------------------------------------
%\newpage
%\listoftodos[\section{Todo-Notes}]
%\clearpage

\end{document}
