nussinussi/Projekt6Thesis/Benutzerhanbuch/Latex Benutzerhanbuch/Benutzerhandbuch/Benutzerhanndbuch.tex

\documentclass[final]{fhnwreport}       %[mode] = draft or final
                                        %{class} = fhnwreport, article, 
                                        %          report, book, beamer, standalone
\input{header}			                %loads all packages, definitions and settings											
\title{Benutzerhandbuch IoT-Raumautomation}  		        %Project Title
%\author{Team 1}      				    %Document Type => Technical Report, ...
%\date{\today}          				%Place and Date

\begin{document}

%%---TITLEPAGE---------------------------------------------------------------------------------
\thispagestyle{empty}
%	\ohead{\includegraphics[scale=0.5]{Bilder/Logo_FHNW.jpg}}
	\begin{figure}
		 \vspace*{-\topskip}\vspace*{-\headsep}
		
	\end{figure}

	\begin{center}
		\vspace*{2cm}
		{\huge{\textbf{\thetitle}}}\\
		\vspace*{0.5cm}
		
	%	{\scshape\Large Artikel Kryptographie \\} 
		\Large{Windisch, \today}
		
		\vspace*{-1cm}						    %compensates the space after the date line.
		\vfill

		\vfill
		
		\begin{normalsize}
			{
			\renewcommand\arraystretch{2}
			\begin{tabular}{>{\bf}p{4cm} l}
			Autoren   		           & 	Gabriel Nussbaumer und Lukas Meienberger\\

			Hochschule                 &    Hochschule für Technik - FHNW\\
			Studiengang                &    Elektro- und Informationstechnik\\
%			Version                    &    1.0 %Normally not used!
			\end{tabular}
			}
		\end{normalsize}
	\end{center}
\clearpage
			
%%---ABSTRACT----------------------------------------------------------------------------
%\selectlanguage{english}				%ngerman or english
%\thispagestyle{empty}
%\include{sections/abstract}

%%---TABLE OF CONTENTS-------------------------------------------------------------------
\pagenumbering{Roman}		
\selectlanguage{ngerman}				%ngerman or english
\tableofcontents
\clearpage

%%---TEXT--------------------------------------------------------------------------------
\pagenumbering{arabic}

\input{sections/Aktor}
\input{sections/Semsor}
\input{sections/Openhab}
\input{sections/Sprachassistant}
\input{sections/Schluss}
\pagebreak

%\clearpage
%%---BIBLIOGRAPHY------------------------------------------------------------------------

{\sloppypar
%\printbibliography[heading=bibnumbered ]
\label{sec:lit}
\selectlanguage{ngerman}				%ngerman or english
\printbibliography
}

%\pagebreak

%\input{sections/8_0_Ehrlichkeitserklaerung}
%\pagebreak
%%---APPENDIX----------------------------------------------------------------------------
%\appendix
%\include{sections/appendix}

%%---NOTES for DEBUG---------------------------------------------------------------------
%\ifdraft{%Do this only if mode=draft
%\usepackage{todonotes})
%\newpage
%\listoftodos[\section{Todo-Notes}]
%\clearpage
%}
%{%Do this only if mode=final
%}

\end{document}
