nussinussi/Projekt6Thesis/Präsentation/Zwischenpräsi.pptx

## IOT-Raumautomation mit MQTT-Protokoll

Lukas Meienberger und Gabriel Nussbaumer

## Übersicht

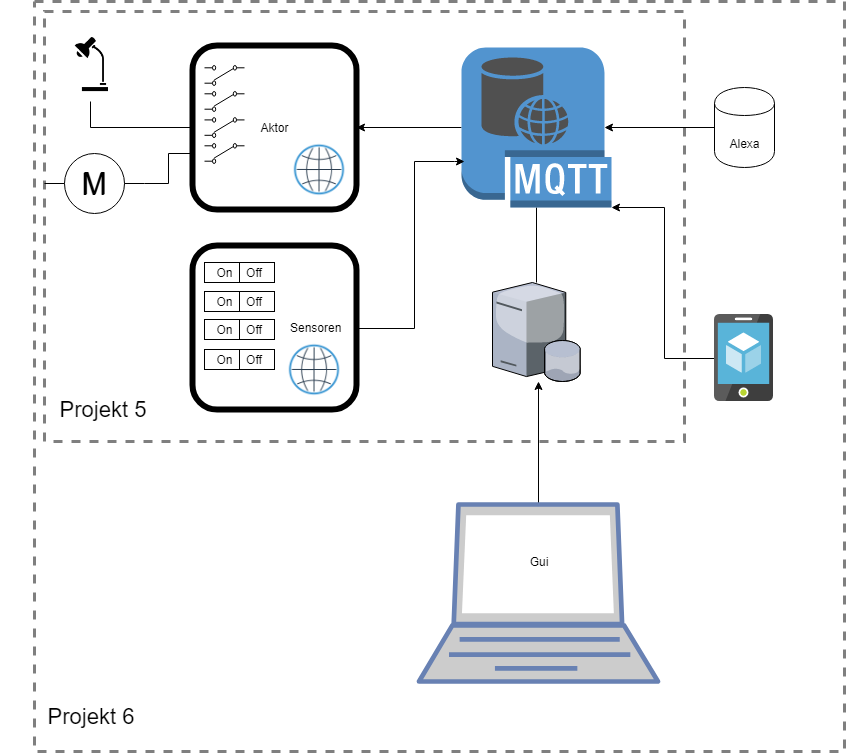
[picture p100: figure]

## Zeitplan

## Covid

- Projektwoche wurde gestrichen
- Die Thesis-Ausstellung vom Freitag 14. August ist ersatzlos gestrichen. Die Plakate (je nach Studiengang Webauftritte statt Plakate) müssen Sie aber erstellen. Die Plakate natürlich nur als PDF. Das ist keine Schikane, sondern eine Kommunikationsübung.

## Resultate

- Sensorbaustein
- Aktorbaustein
- Openhab
- Sprachassistent
- Demo

## Probleme SW

- Kommunikation mit Sprach-Assistent
- Implementierung Reset Funktion -> Authentifizierung zurücksetzen

## Probleme HW

## Neuer Zeitplan
