nussinussi/Projekt6Thesis/Benutzerhanbuch/Latex Benutzerhanbuch/Benutzerhandbuch/graphics/Titelbild1.jpg

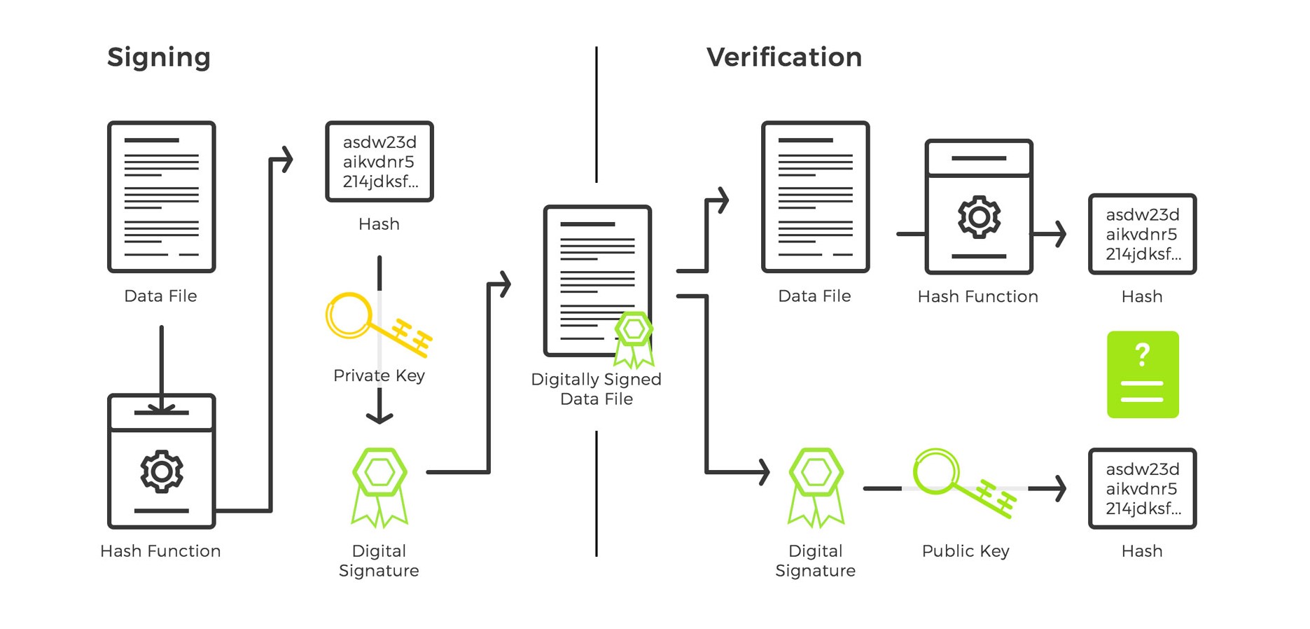
Benutzerhanbuch/Latex Benutzerhanbuch/Benutzerhandbuch/graphics/Titelbild1.jpg
