nussinussi/Projekt6Thesis/Benutzerhanbuch/Latex Benutzerhanbuch/Benutzerhandbuch/graphics/Titelbild2.jpg

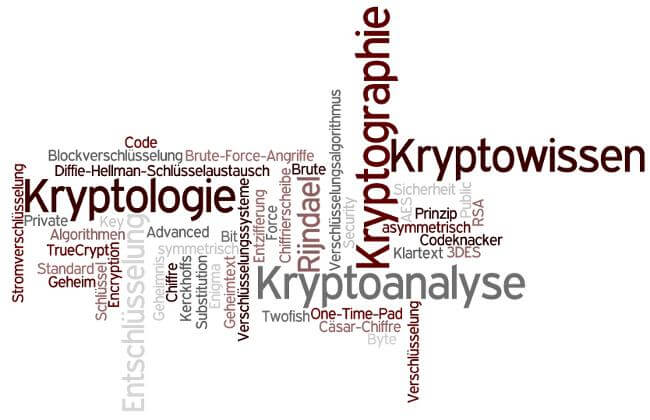
Benutzerhanbuch/Latex Benutzerhanbuch/Benutzerhandbuch/graphics/Titelbild2.jpg
