nussinussi/Projekt6Thesis/Benutzerhanbuch/Latex Benutzerhanbuch/Benutzerhandbuch/graphics/Titelbild.png

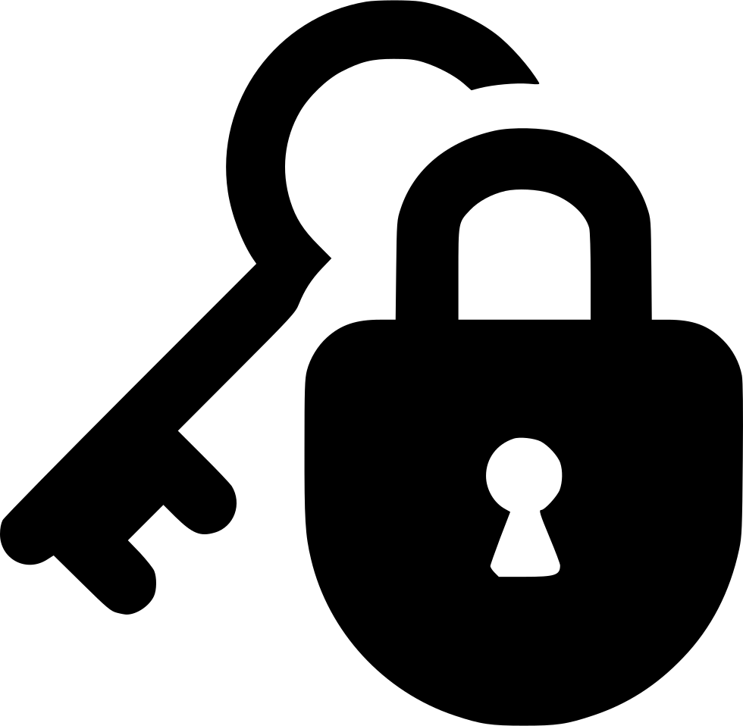
Benutzerhanbuch/Latex Benutzerhanbuch/Benutzerhandbuch/graphics/Titelbild.png
