nussinussi/Projekt6Thesis/Benutzerhanbuch/Latex Benutzerhanbuch/Benutzerhandbuch/graphics/Titelbild_Original.jpg

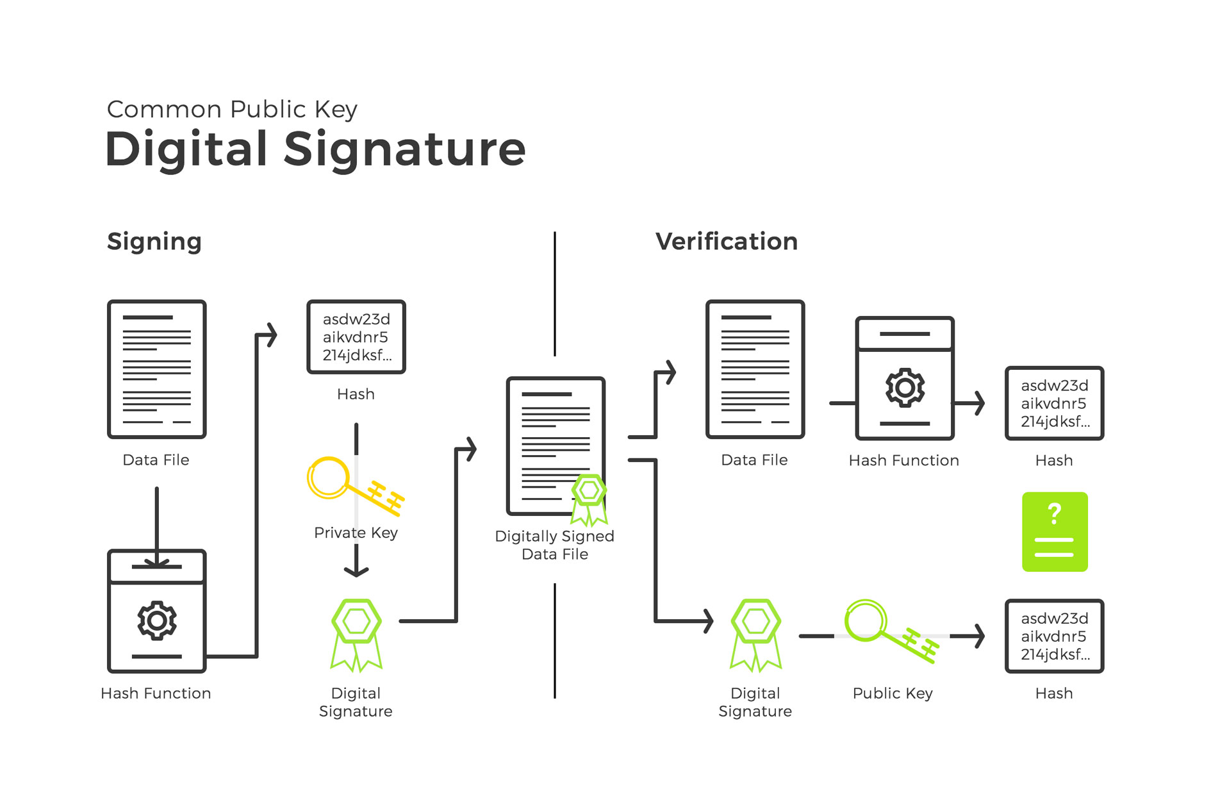
Benutzerhanbuch/Latex Benutzerhanbuch/Benutzerhandbuch/graphics/Titelbild_Original.jpg
