nussinussi/Projekt6Thesis/Fachbericht/graphics/blockdiagrammCC3235.PNG

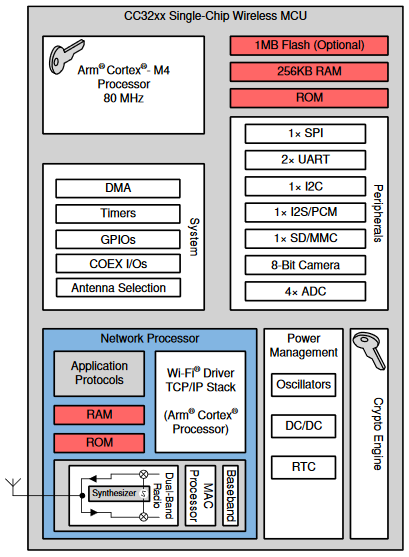
Fachbericht/graphics/blockdiagrammCC3235.PNG
