nussinussi/Projekt6Thesis/Fachbericht/graphics/blockdiagrammESP32.PNG

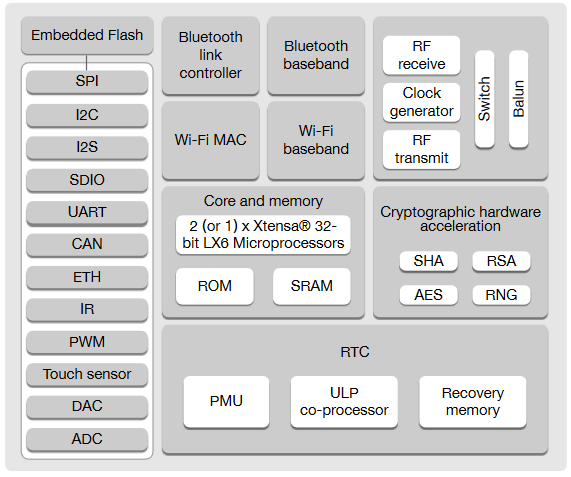
Fachbericht/graphics/blockdiagrammESP32.PNG
