nussinussi/Projekt6Thesis/Fachbericht/graphics/Grafana.PNG

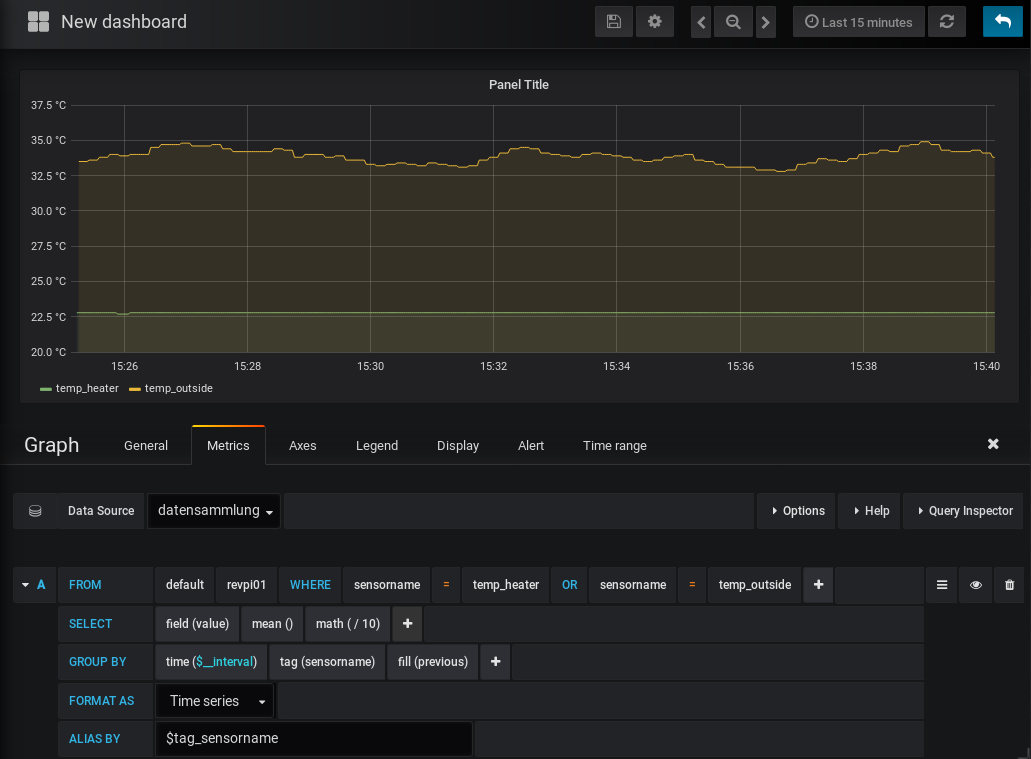
Fachbericht/graphics/Grafana.PNG
