nussinussi/Projekt6Thesis/Fachbericht/graphics/Messfühler.jpg

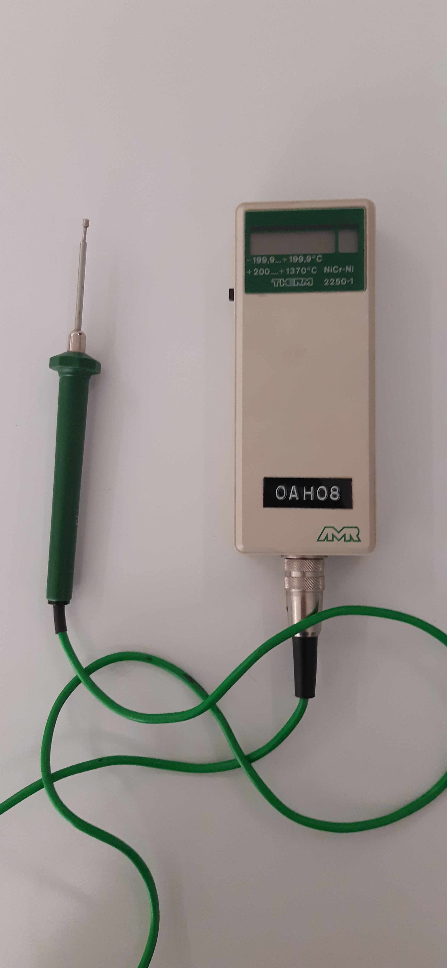
Fachbericht/graphics/Messfühler.jpg
