nussinussi/Projekt6Thesis/Fachbericht/graphics/Messwerte_Temperatur.jpg

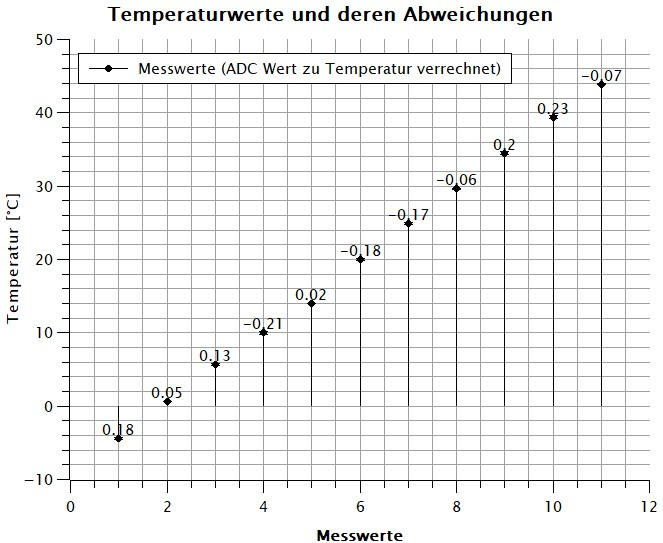
Fachbericht/graphics/Messwerte_Temperatur.jpg
