nussinussi/Projekt6Thesis/Fachbericht/graphics/MosquittoStatus.PNG

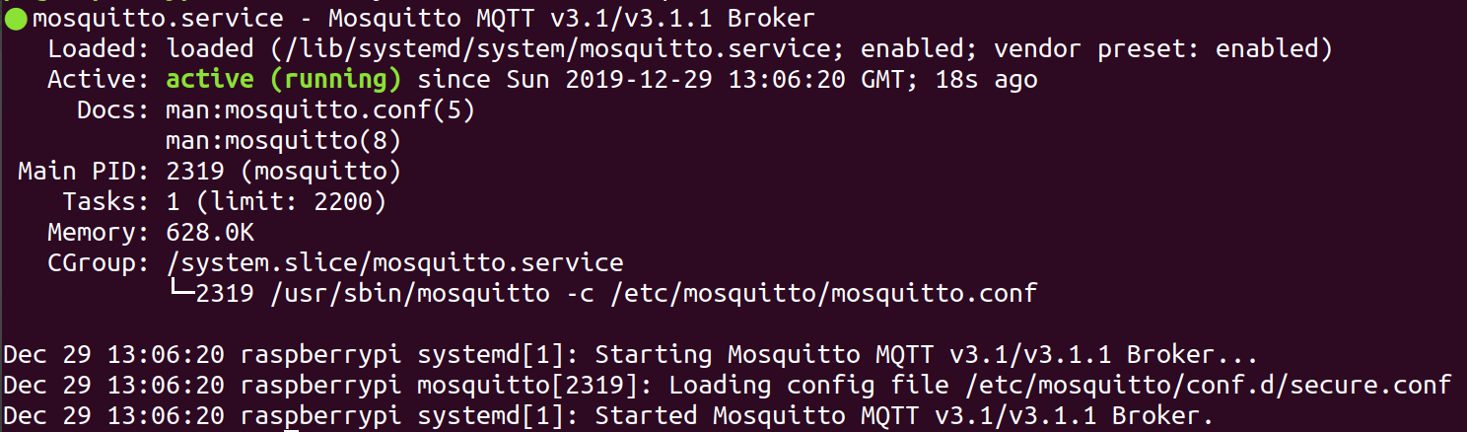
Fachbericht/graphics/MosquittoStatus.PNG
