nussinussi/Projekt6Thesis/Fachbericht/graphics/PIO.PNG

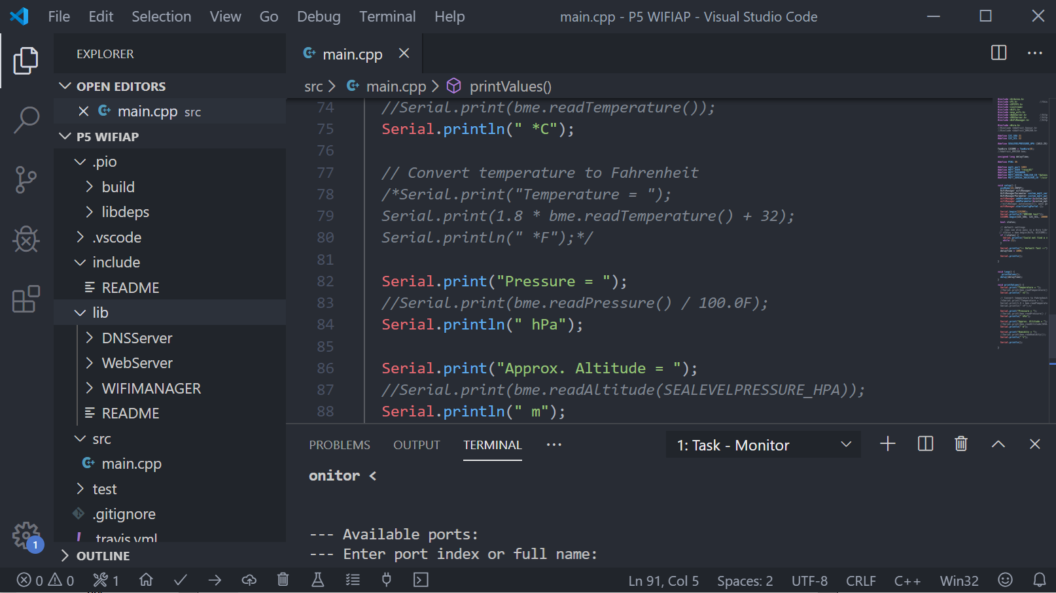
Fachbericht/graphics/PIO.PNG
