nussinussi/Projekt6Thesis/Fachbericht/graphics/shematics_sensor_stecker.png

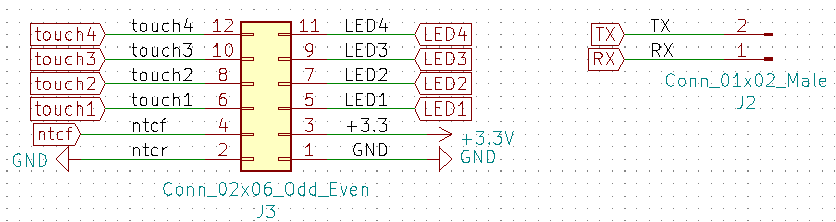
Fachbericht/graphics/shematics_sensor_stecker.png
