nussinussi/Projekt6Thesis/Fachbericht/graphics/TitelbildP5.png

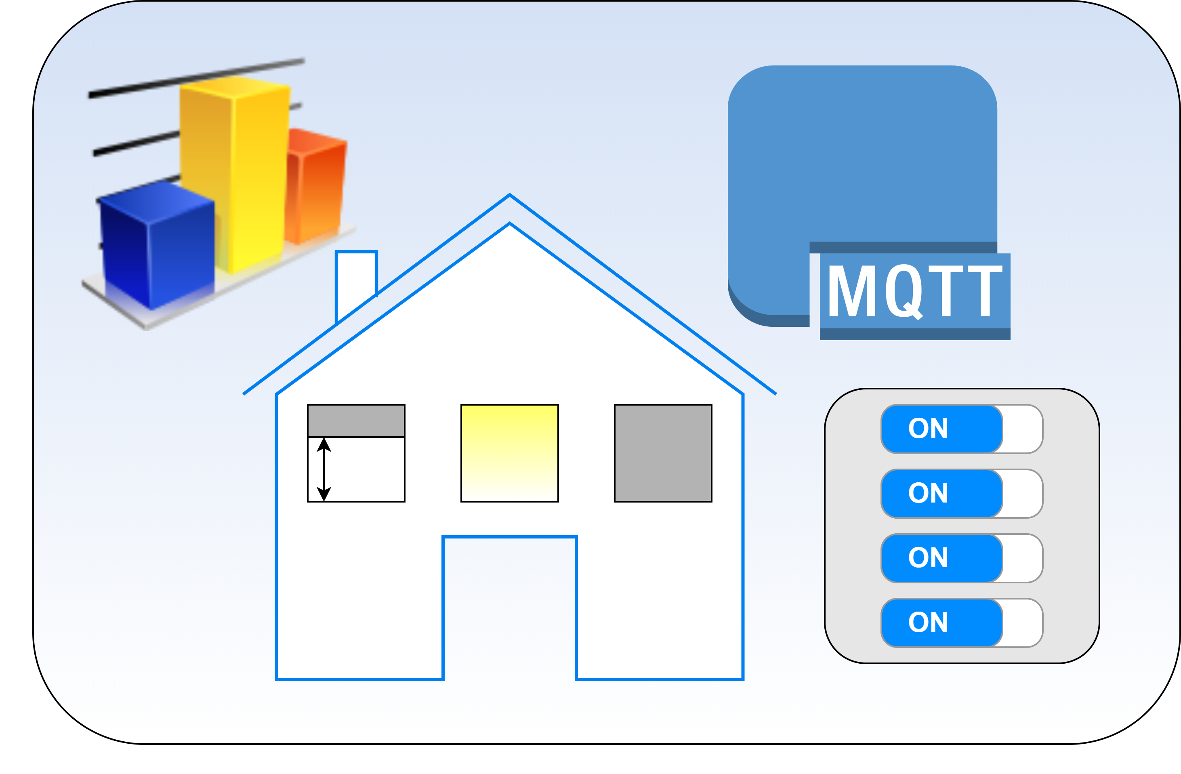
Fachbericht/graphics/TitelbildP5.png
