nussinussi/Projekt6Thesis/Fachbericht/graphics/useracl.PNG

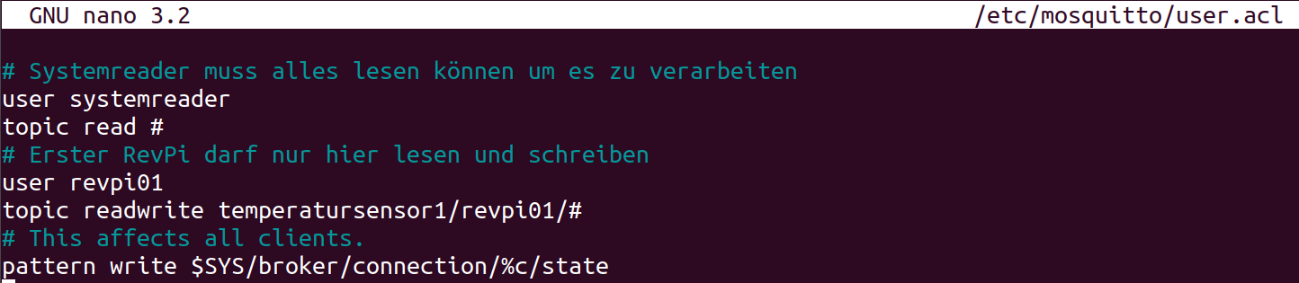
Fachbericht/graphics/useracl.PNG
