nussinussi/Projekt6Thesis/Fachbericht/graphics/WifiHome.PNG

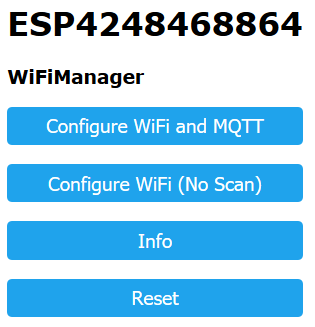
Fachbericht/graphics/WifiHome.PNG
