nussinussi/Projekt6Thesis/Fachbericht/graphics/Wifiinfo.PNG

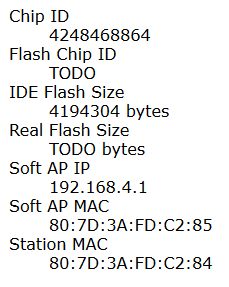
Fachbericht/graphics/Wifiinfo.PNG
