nussinussi/Projekt6Thesis/Fachbericht/graphics/WifiKonfig.PNG

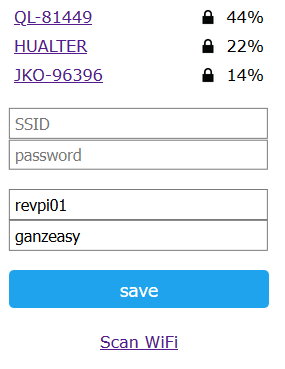
Fachbericht/graphics/WifiKonfig.PNG
