nussinussi/Projekt6Thesis/Fachbericht/graphics/WifiNetz.png

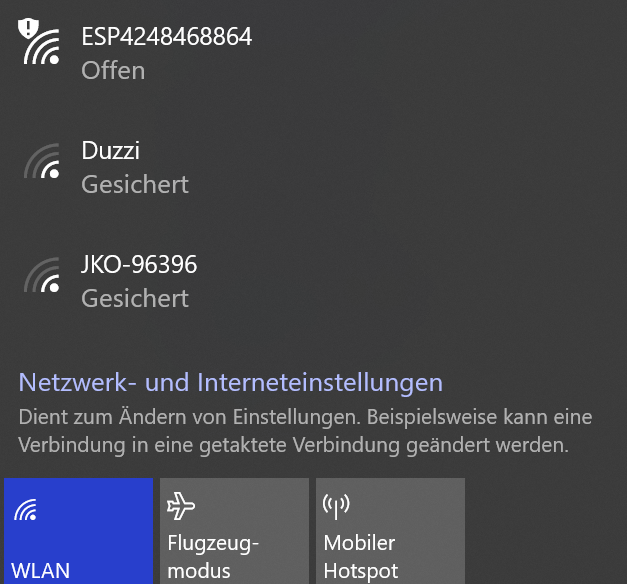
Fachbericht/graphics/WifiNetz.png
