nussinussi/Projekt6Thesis/Fachbericht/graphics/WPAsupplicant.PNG

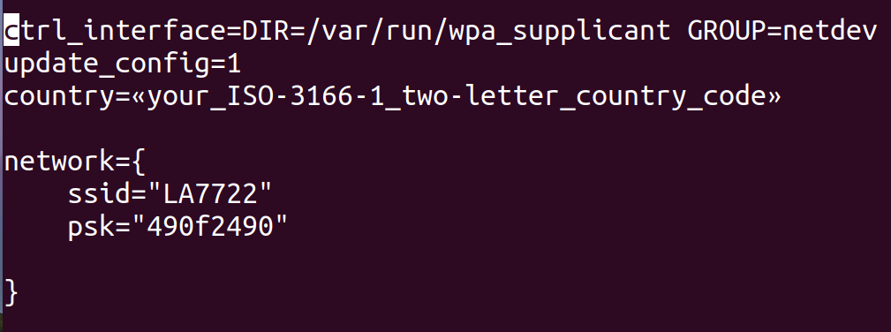
Fachbericht/graphics/WPAsupplicant.PNG
