nussinussi/Projekt6Thesis/Fachbericht/graphics/youvi.PNG

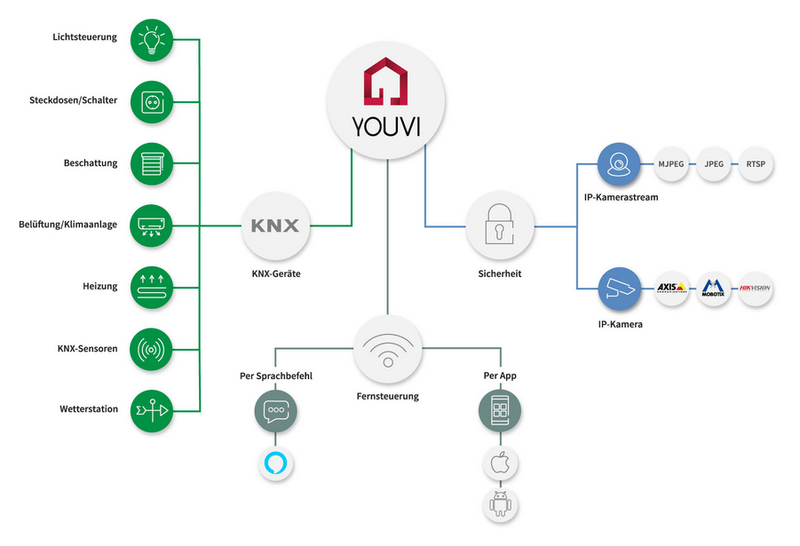
Fachbericht/graphics/youvi.PNG
