nussinussi/Projekt6Thesis/Fachbericht/graphics/youviVisu.PNG

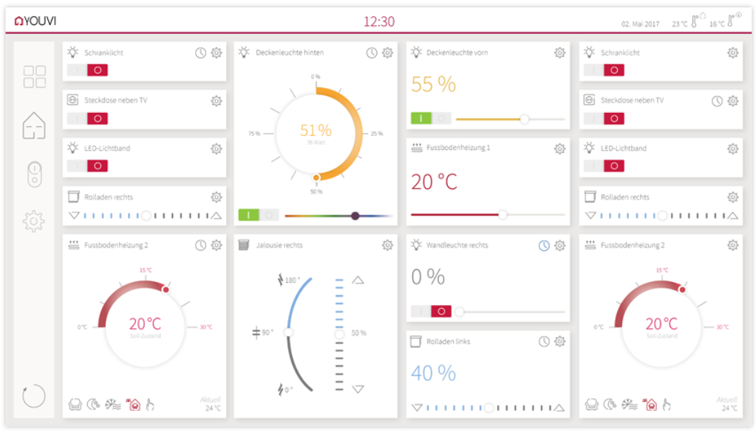
Fachbericht/graphics/youviVisu.PNG
