nussinussi/Projekt6Thesis/Benutzerhanbuch/Latex Benutzerhanbuch/Benutzerhandbuch/sections/Installation Aktor.tex

\clearpage
\section{Installation Aktor}\label{sec: Installation Aktor}
