nussinussi/Projekt6Thesis/Hardware/Spannungsversorgung_1.1/Spannungsversorgung.kicad_pcb

## KiCad design Hardware/Spannungsversorgung_1.1/Spannungsversorgung.kicad_pcb (2020-07-04)

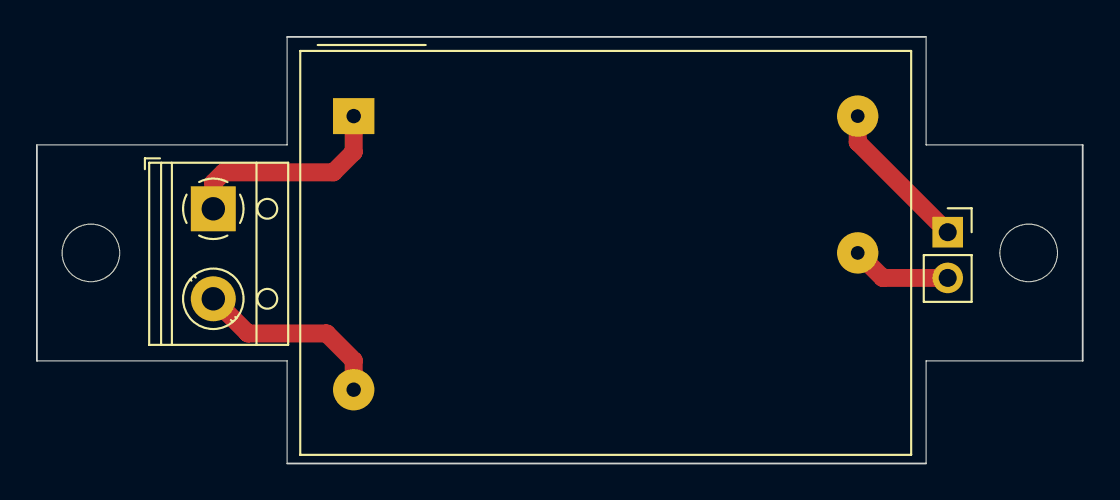
[picture p122: board Spannungsversorgung.kicad_pcb from above]

Board: 2 copper layers, 58.1 x 23.7 mm, 5 parts (0 on the bottom side), 4 nets.

Parts:
H1, H2: MountingHole; MountingHole_3.2mm_M3_ISO14580
J1: Screw_Terminal_01x02; TerminalBlock_RND_205-00012_1x02_P5.00mm_Horizontal
J2: Conn_01x02_Male; PinSocket_1x02_P2.54mm_Vertical
PS1: IRM-02-5; Converter_ACDC_MeanWell_IRM-02-xx_THT

Connections:
unnamed: J1.1, PS1.1
unnamed: J1.2, PS1.2
unnamed: J2.1, PS1.3
unnamed: J2.2, PS1.4
