nussinussi/Projekt6Thesis/Hardware/Aktorbaustein_v2.6/Aktorbaustein.kicad_pcb

## KiCad design Hardware/Aktorbaustein_v2.6/Aktorbaustein.kicad_pcb (2020-08-14)

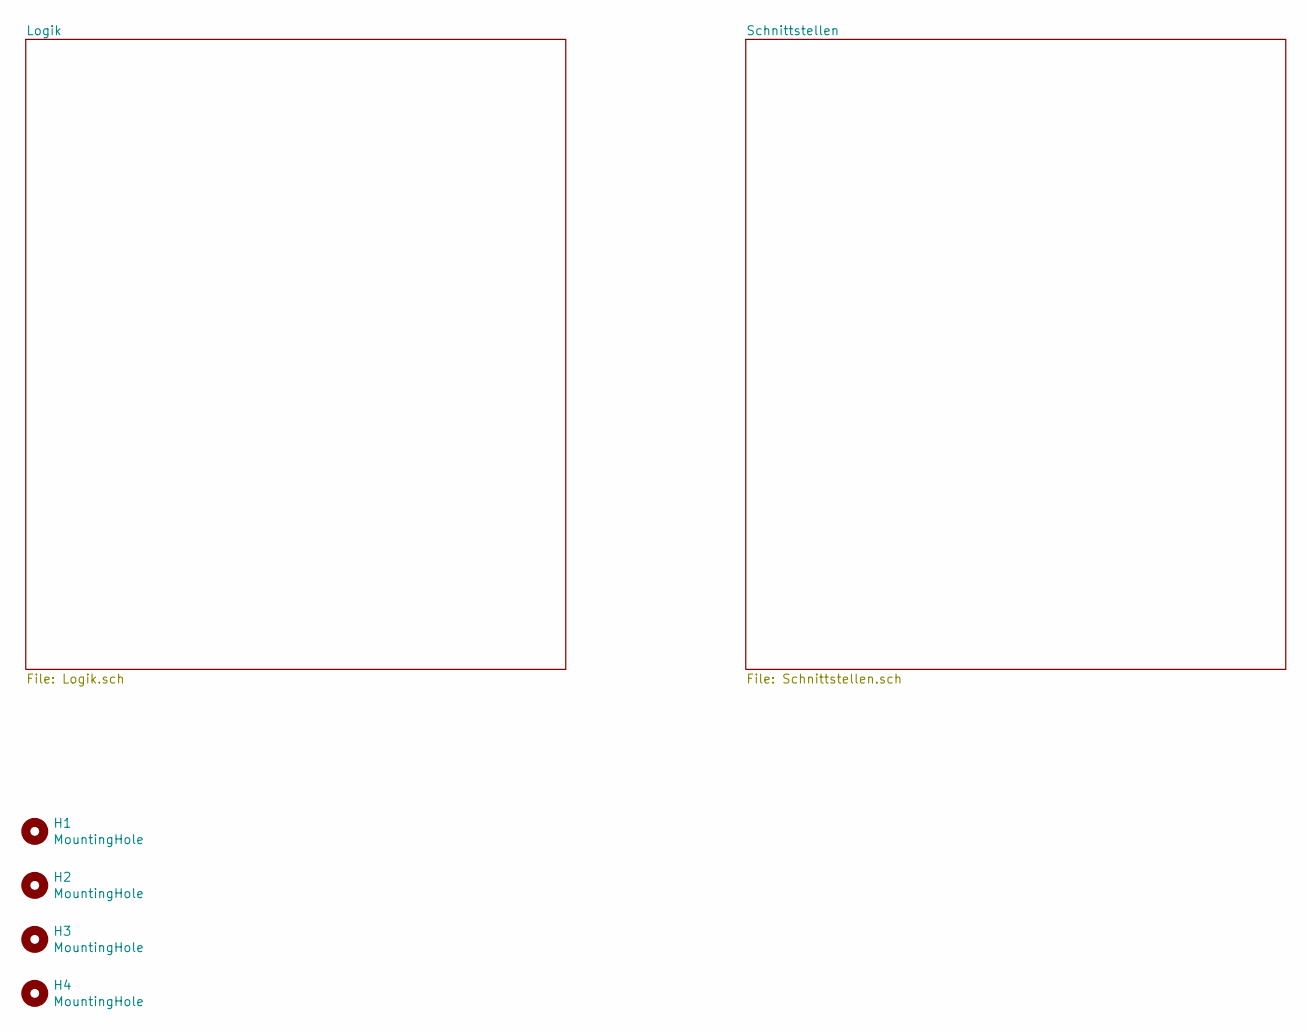
[picture p123: schematic Aktorbaustein.sch]

Parts:
H1, H2, H3, H4: MountingHole; MountingHole_3.2mm_M3_ISO7380

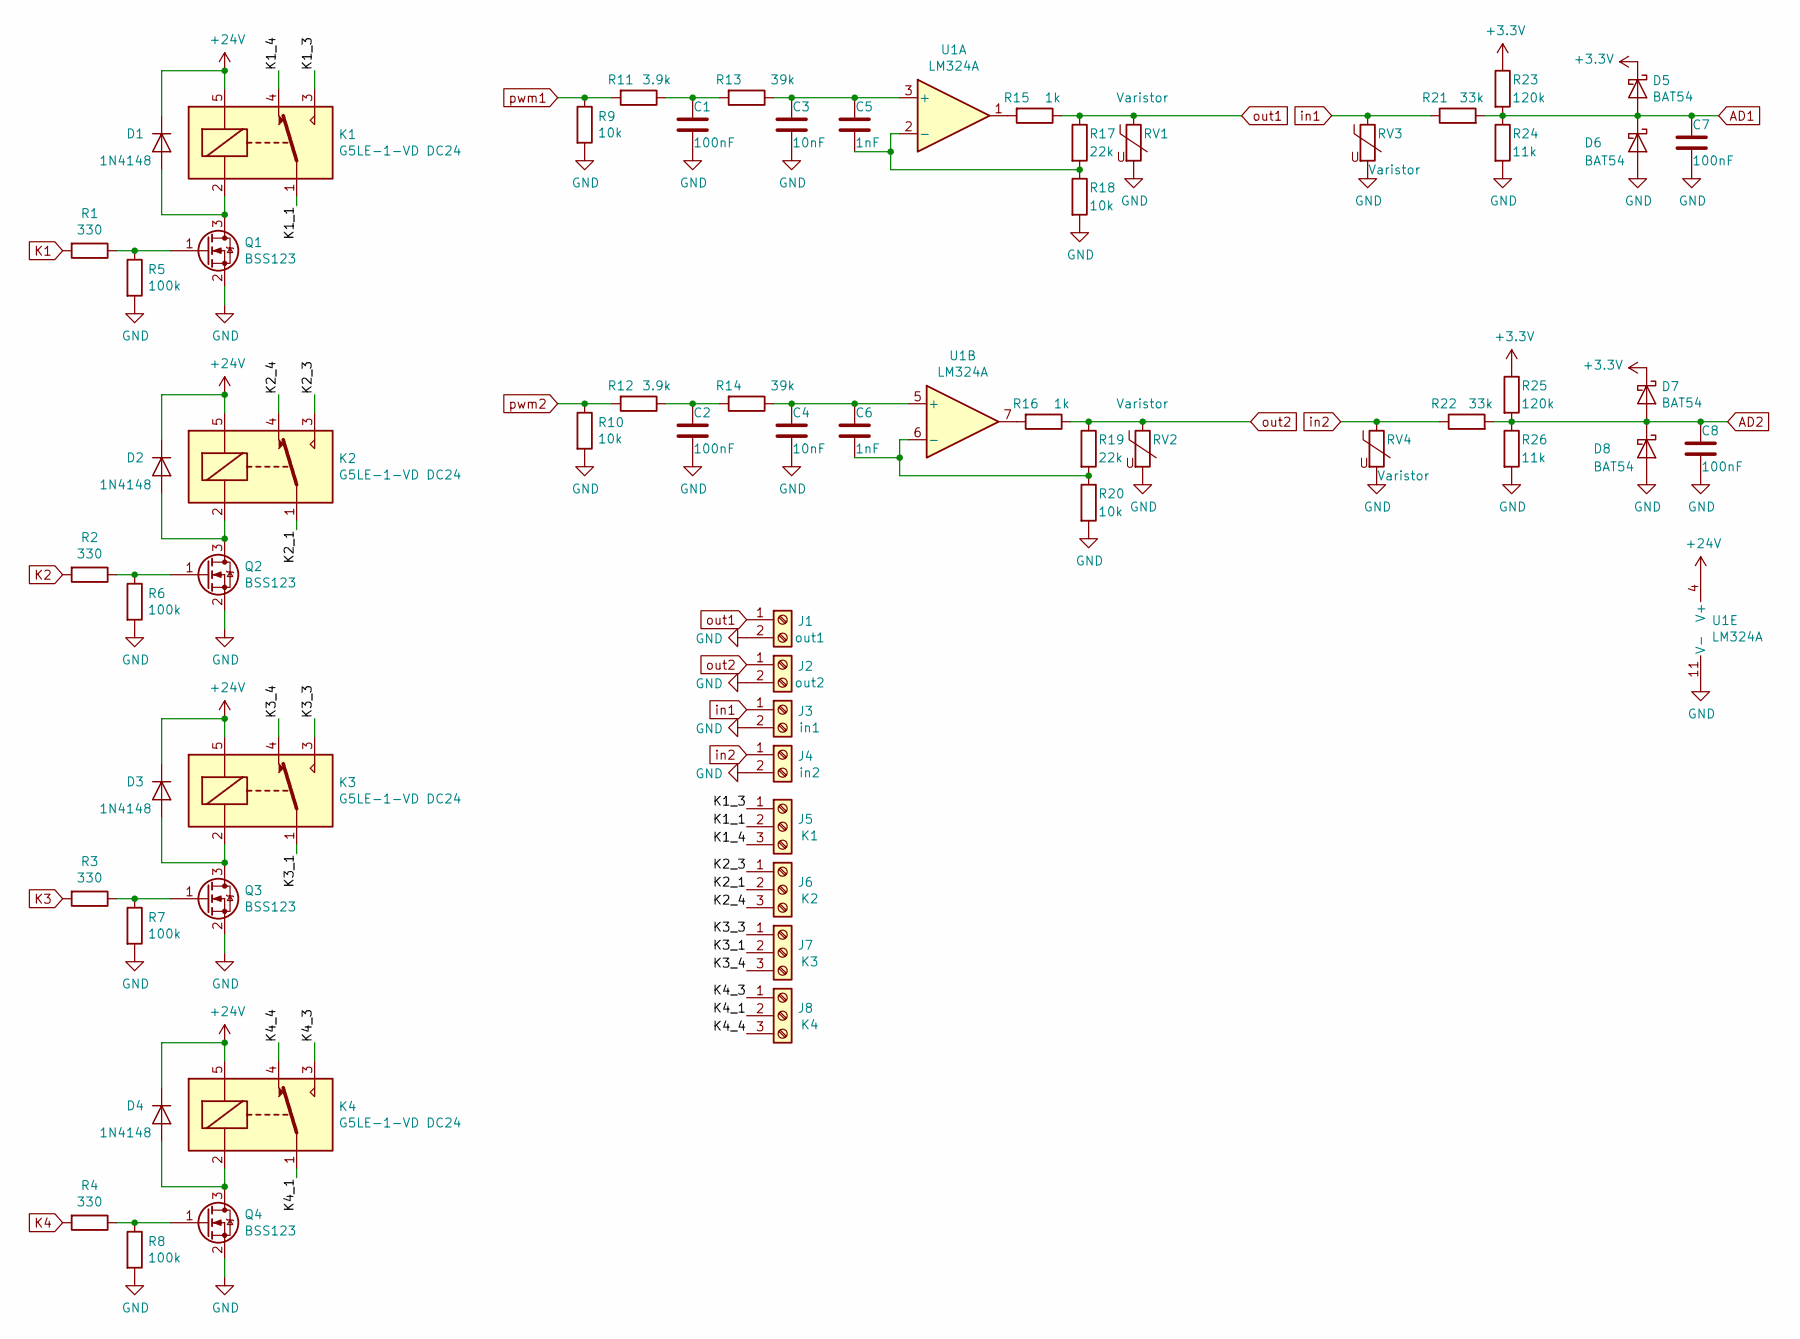
[picture p124: schematic Schnittstellen.sch]

Parts:
C1, C2, C7, C8: 100nF; C_0603_1608Metric_Pad1.05x0.95mm_HandSolder
C3, C4: 10nF; C_0603_1608Metric_Pad1.05x0.95mm_HandSolder
C5, C6: 1nF; C_0603_1608Metric_Pad1.05x0.95mm_HandSolder
D1, D2, D3, D4: 1N4148; D_DO-35_SOD27_P7.62mm_Horizontal
D5, D6, D7, D8: BAT54; D_SOT-23_ANK
J1, J2, J3, J4: TB001-500-02BE; TerminalBlock_RND_205-00012_1x02_P5.00mm_Horizontal
J5, J6, J7, J8: TB002-500-03BE; TerminalBlock_RND_205-00013_1x03_P5.00mm_Horizontal
K1, K2, K3, K4: G5LE-1-VD DC24; Relay_SPDT_Omron-G5LE-1
Q1, Q2, Q3, Q4: BSS123; SOT-23
R1, R2, R3, R4: 330; R_0603_1608Metric_Pad1.05x0.95mm_HandSolder
R5, R6, R7, R8: 100k; R_0603_1608Metric_Pad1.05x0.95mm_HandSolder
R9, R10, R18, R20: 10k; R_0603_1608Metric_Pad1.05x0.95mm_HandSolder
R11, R12: 3.9k; R_0603_1608Metric_Pad1.05x0.95mm_HandSolder
R13, R14: 39k; R_0603_1608Metric_Pad1.05x0.95mm_HandSolder
R15, R16: 1k; R_0603_1608Metric_Pad1.05x0.95mm_HandSolder
R17, R19: 22k; R_0603_1608Metric_Pad1.05x0.95mm_HandSolder
R21, R22: 33k; R_0603_1608Metric_Pad1.05x0.95mm_HandSolder
R23, R25: 120k; R_0603_1608Metric_Pad1.05x0.95mm_HandSolder
R24, R26: 11k; R_0603_1608Metric_Pad1.05x0.95mm_HandSolder
RV1, RV2, RV3, RV4: Varistor; R_0402_1005Metric
U1: LM324A; SOIC-14_3.9x8.7mm_P1.27mm

Connections:
+3V3: D5.1 (K), D7.1 (K), R23.1, R25.1; also elsewhere on the board
+24V: D1.1 (K), D2.1 (K), D3.1 (K), D4.1 (K), K1.5, K2.5, K3.5, K4.5, U1.4 (V+); also elsewhere on the board
/Schnittstellen/K1_1: J5.2, K1.1
/Schnittstellen/K1_3: J5.1, K1.3
/Schnittstellen/K1_4: J5.3, K1.4
/Schnittstellen/K2_1: J6.2, K2.1
/Schnittstellen/K2_3: J6.1, K2.3
/Schnittstellen/K2_4: J6.3, K2.4
/Schnittstellen/K3_1: J7.2, K3.1
/Schnittstellen/K3_3: J7.1, K3.3
/Schnittstellen/K3_4: J7.3, K3.4
/Schnittstellen/K4_1: J8.2, K4.1
/Schnittstellen/K4_3: J8.1, K4.3
/Schnittstellen/K4_4: J8.3, K4.4
AD1: C7.1, D5.2 (A), D6.1 (K), R21.2, R23.2, R24.1; also elsewhere on the board
AD2: C8.1, D7.2 (A), D8.1 (K), R22.2, R25.2, R26.1; also elsewhere on the board
GND: C1.2, C2.2, C3.2, C4.2, C7.2, C8.2, D6.2 (A), D8.2 (A), J1.2, J2.2, J3.2, J4.2, Q1.2 (S), Q2.2 (S), Q3.2 (S), Q4.2 (S), R5.2, R6.2, R7.2, R8.2, R9.2, R10.2, R18.2, R20.2, R24.2, R26.2, RV1.2, RV2.2, RV3.2, RV4.2, U1.11 (V-); also elsewhere on the board
K1: R1.2; also elsewhere on the board
K2: R2.2; also elsewhere on the board
K3: R3.2; also elsewhere on the board
K4: R4.2; also elsewhere on the board
unnamed: C1.1, R11.1, R13.2
unnamed: C2.1, R12.1, R14.2
unnamed: C3.1, C5.1, R13.1, U1.3 (+)
unnamed: C4.1, C6.1, R14.1, U1.5 (+)
unnamed: C5.2, R17.2, R18.1, U1.2 (-)
unnamed: C6.2, R19.2, R20.1, U1.6 (-)
unnamed: D1.2 (A), K1.2, Q1.3 (D)
unnamed: D2.2 (A), K2.2, Q2.3 (D)
unnamed: D3.2 (A), K3.2, Q3.3 (D)
unnamed: D4.2 (A), K4.2, Q4.3 (D)
unnamed: Q1.1 (G), R1.1, R5.1
unnamed: Q2.1 (G), R2.1, R6.1
unnamed: Q3.1 (G), R3.1, R7.1
unnamed: Q4.1 (G), R4.1, R8.1
unnamed: R15.2, U1.1
unnamed: R16.2, U1.7
in1: J3.1, R21.1, RV3.1
in2: J4.1, R22.1, RV4.1
out1: J1.1, R15.1, R17.1, RV1.1
out2: J2.1, R16.1, R19.1, RV2.1
pwm1: R9.1, R11.2; also elsewhere on the board
pwm2: R10.1, R12.2; also elsewhere on the board

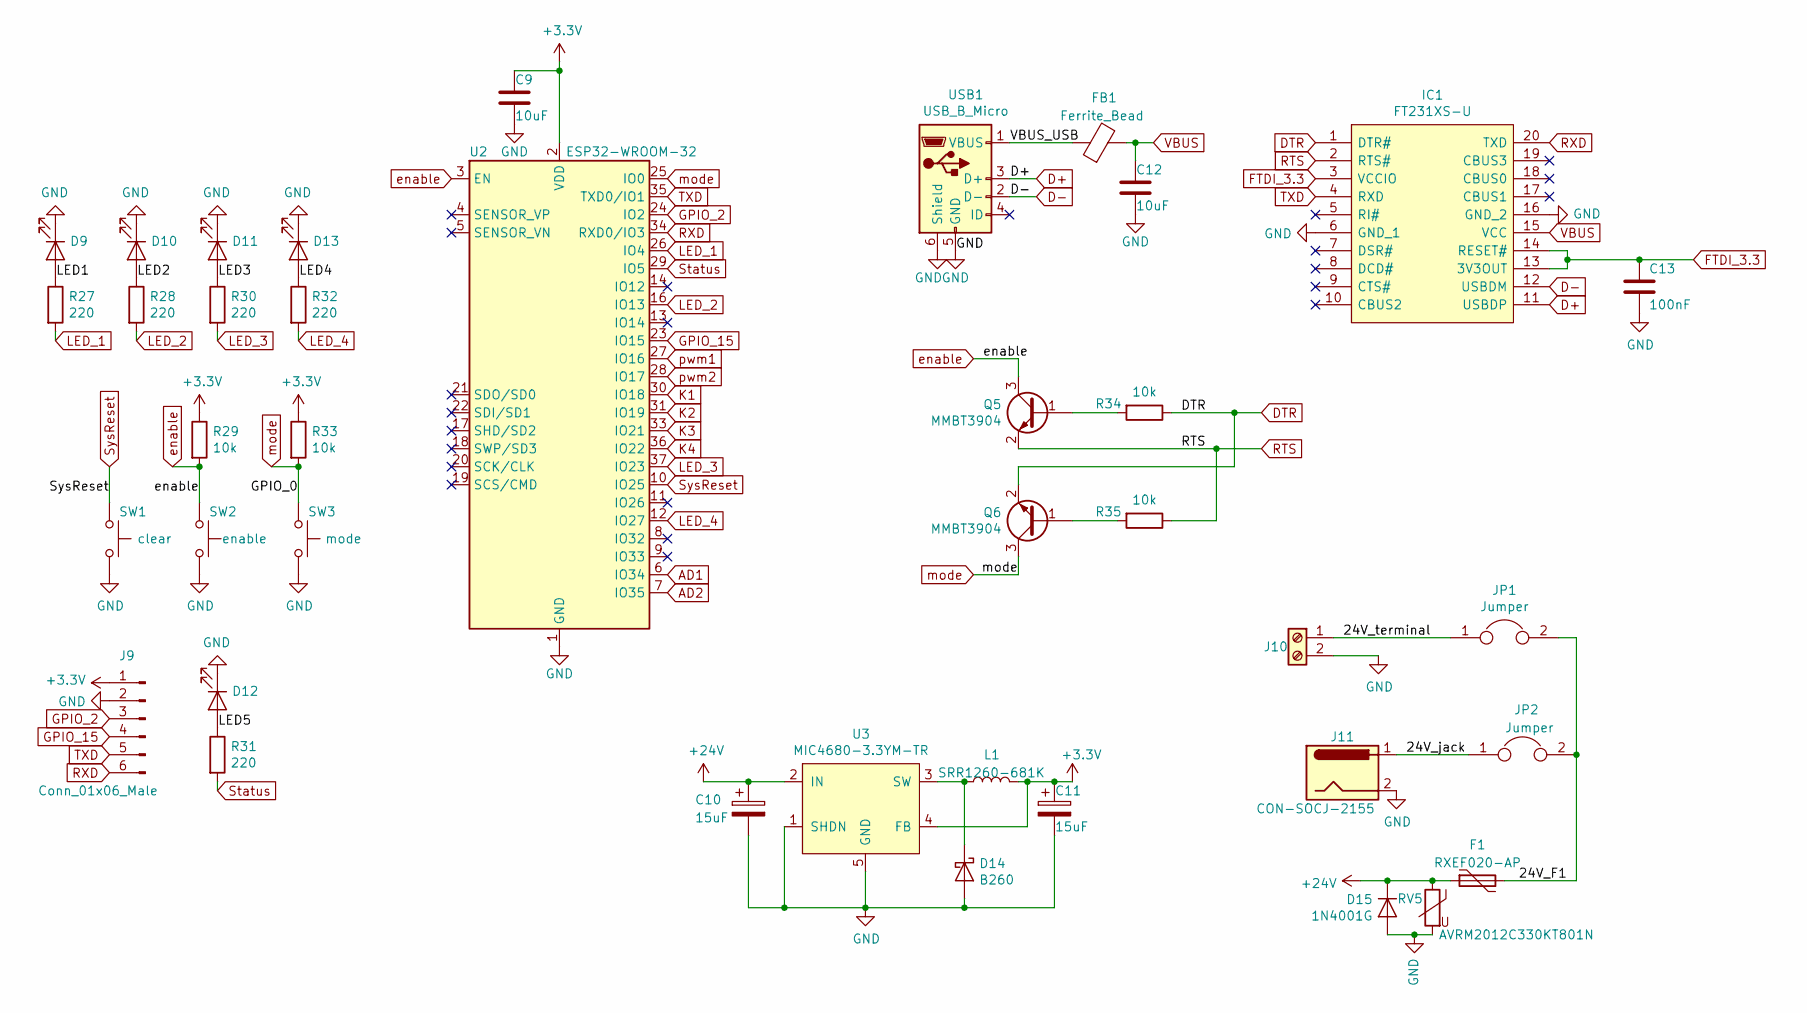
[picture p125: schematic Logik.sch]

Parts:
C9, C12: 10uF; C_0603_1608Metric_Pad1.05x0.95mm_HandSolder
C10, C11: 15uF; CP_Radial_D5.0mm_P2.00mm
C13: 100nF; C_0603_1608Metric_Pad1.05x0.95mm_HandSolder
D9, D10, D11, D13: 150060VS55040; LED_0603_1608Metric_Pad1.05x0.95mm_HandSolder
D12: 150060BS55040; LED_0603_1608Metric_Pad1.05x0.95mm_HandSolder
D14: B260; D_SMB
D15: 1N4001G; D_DO-41_SOD81_P10.16mm_Horizontal
F1: RXEF020-AP; RXEF0252
FB1: Ferrite_Bead; R_0603_1608Metric_Pad1.05x0.95mm_HandSolder
IC1: FT231XS-U; SOP64P599X175-20N; Manufacturer_Part_Number FT231XS-U; Mouser Part Number 895-FT231XS-U
J9: Conn_01x06_Male; PinHeader_1x06_P2.54mm_Vertical
J10: TB003V-500-P02BE; TerminalBlock_RND_205-00012_1x02_P5.00mm_Horizontal
J11: CON-SOCJ-2155; CONSOCJ2155
JP1, JP2: Jumper; PinHeader_1x02_P2.54mm_Vertical
L1: SRR1260-681K; L_12x12mm_H6mm
Q5, Q6: MMBT3904; SOT-23
R27, R28, R30, R31, R32: 220; R_0603_1608Metric_Pad1.05x0.95mm_HandSolder
R29, R33, R34, R35: 10k; R_0603_1608Metric_Pad1.05x0.95mm_HandSolder
RV5: AVRM2012C330KT801N; R_0805_2012Metric_Pad1.15x1.40mm_HandSolder
SW1, SW2, SW3: SKHHALA010; SW_PUSH_6mm_H4.3mm
U2: ESP32-WROOM-32
U3: MIC4680-3.3YM-TR; SOIC127P600X175-8N
USB1: USB_B_Micro; USB_Micro-B_Wuerth_614105150721_Vertical_CircularHoles

Connections:
+3V3: C9.1, C11.1, J9.1, L1.2, R29.1, R33.1, U2.2 (VDD), U3.4 (FB); also elsewhere on the board
+24V: C10.1, D15.1 (K), F1.1, RV5.1, U3.2 (IN); also elsewhere on the board
/Logik/24V_F1: F1.2, JP1.2, JP2.2
/Logik/24V_jack: J11.1, JP2.1
/Logik/24V_terminal: J10.1, JP1.1
/Logik/LED1: D9.2 (A), R27.1
/Logik/LED2: D10.2 (A), R28.1
/Logik/LED3: D11.2 (A), R30.1
/Logik/LED4: D13.2 (A), R32.1
/Logik/LED5: D12.2 (A), R31.1
/Logik/VBUS_USB: FB1.1, USB1.1 (VBUS)
AD1: U2.6 (IO34); also elsewhere on the board
AD2: U2.7 (IO35); also elsewhere on the board
D+: IC1.11 (USBDP), USB1.3 (D+)
D-: IC1.12 (USBDM), USB1.2 (D-)
DTR: IC1.1 (DTR#), Q6.2 (E), R34.1
FTDI_3.3: C13.1, IC1.3 (VCCIO), IC1.13 (3V3OUT), IC1.14 (RESET#)
GND: C9.2, C10.2, C11.2, C12.2, C13.2, D9.1 (K), D10.1 (K), D11.1 (K), D12.1 (K), D13.1 (K), D14.2 (A), D15.2 (A), IC1.6 (GND_1), IC1.16 (GND_2), J9.2, J10.2, J11.2, RV5.2, SW1.2, SW2.2, SW3.2, U2.1 (GND), U2.15 (GND), U2.38 (GND), U3.1 (SHDN), U3.5 (GND), U3.6 (GND), U3.7 (GND), U3.8 (GND), USB1.5 (GND), USB1.6 (Shield); also elsewhere on the board
GPIO_2: J9.3, U2.24 (IO2)
GPIO_15: J9.4, U2.23 (IO15)
K1: U2.30 (IO18); also elsewhere on the board
K2: U2.31 (IO19); also elsewhere on the board
K3: U2.33 (IO21); also elsewhere on the board
K4: U2.36 (IO22); also elsewhere on the board
LED_1: R27.2, U2.26 (IO4)
LED_2: R28.2, U2.16 (IO13)
LED_3: R30.2, U2.37 (IO23)
LED_4: R32.2, U2.12 (IO27)
unnamed: D14.1 (K), L1.1, U3.3 (SW)
unnamed: Q5.1 (B), R34.2
unnamed: Q6.1 (B), R35.2
RTS: IC1.2 (RTS#), Q5.2 (E), R35.1
RXD: IC1.20 (TXD), J9.6, U2.34 (RXD0/IO3)
Status: R31.2, U2.29 (IO5)
SysReset: SW1.1, U2.10 (IO25)
TXD: IC1.4 (RXD), J9.5, U2.35 (TXD0/IO1)
VBUS: C12.1, FB1.2, IC1.15 (VCC)
enable: Q5.3 (C), R29.2, SW2.1, U2.3 (EN)
mode: Q6.3 (C), R33.2, SW3.1, U2.25 (IO0)
pwm1: U2.27 (IO16); also elsewhere on the board
pwm2: U2.28 (IO17); also elsewhere on the board

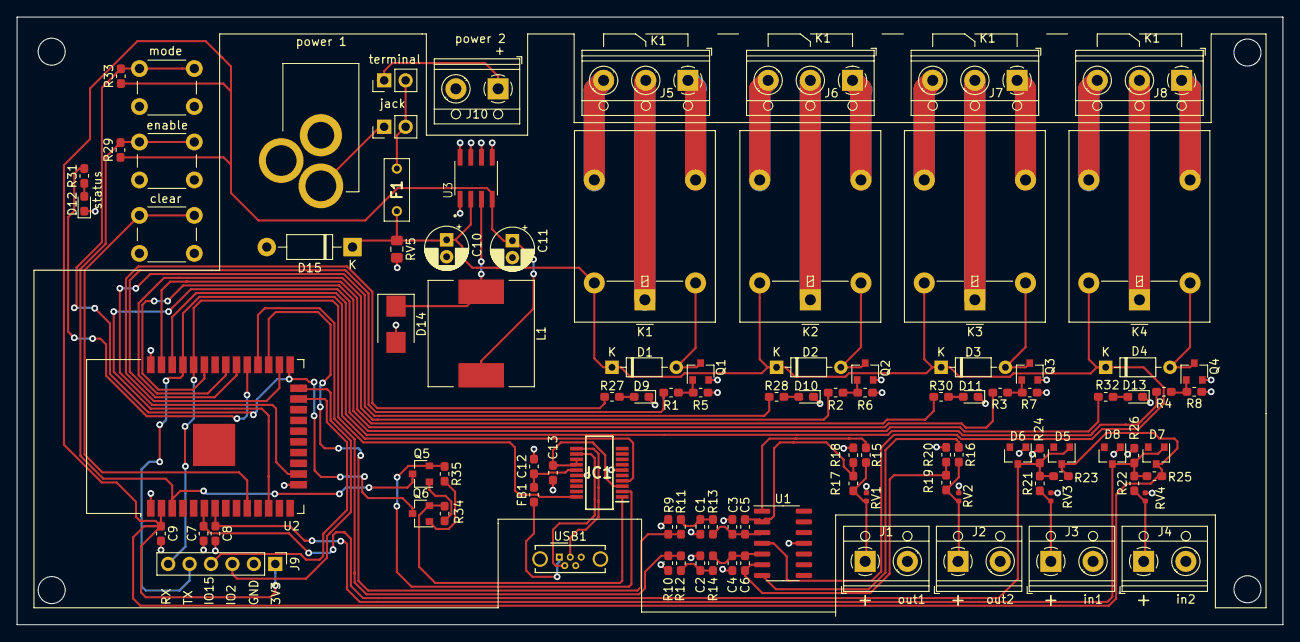
[picture p126: board Aktorbaustein.kicad_pcb from above]

Board: 2 copper layers, 150.0 x 72.0 mm, 106 parts (0 on the bottom side), 73 nets.
