nussinussi/Projekt6Thesis/Hardware/Sensorbaustein_v3.6/Sensorbaustein.kicad_pcb

## KiCad design Hardware/Sensorbaustein_v3.6/Sensorbaustein.kicad_pcb (2020-06-28)

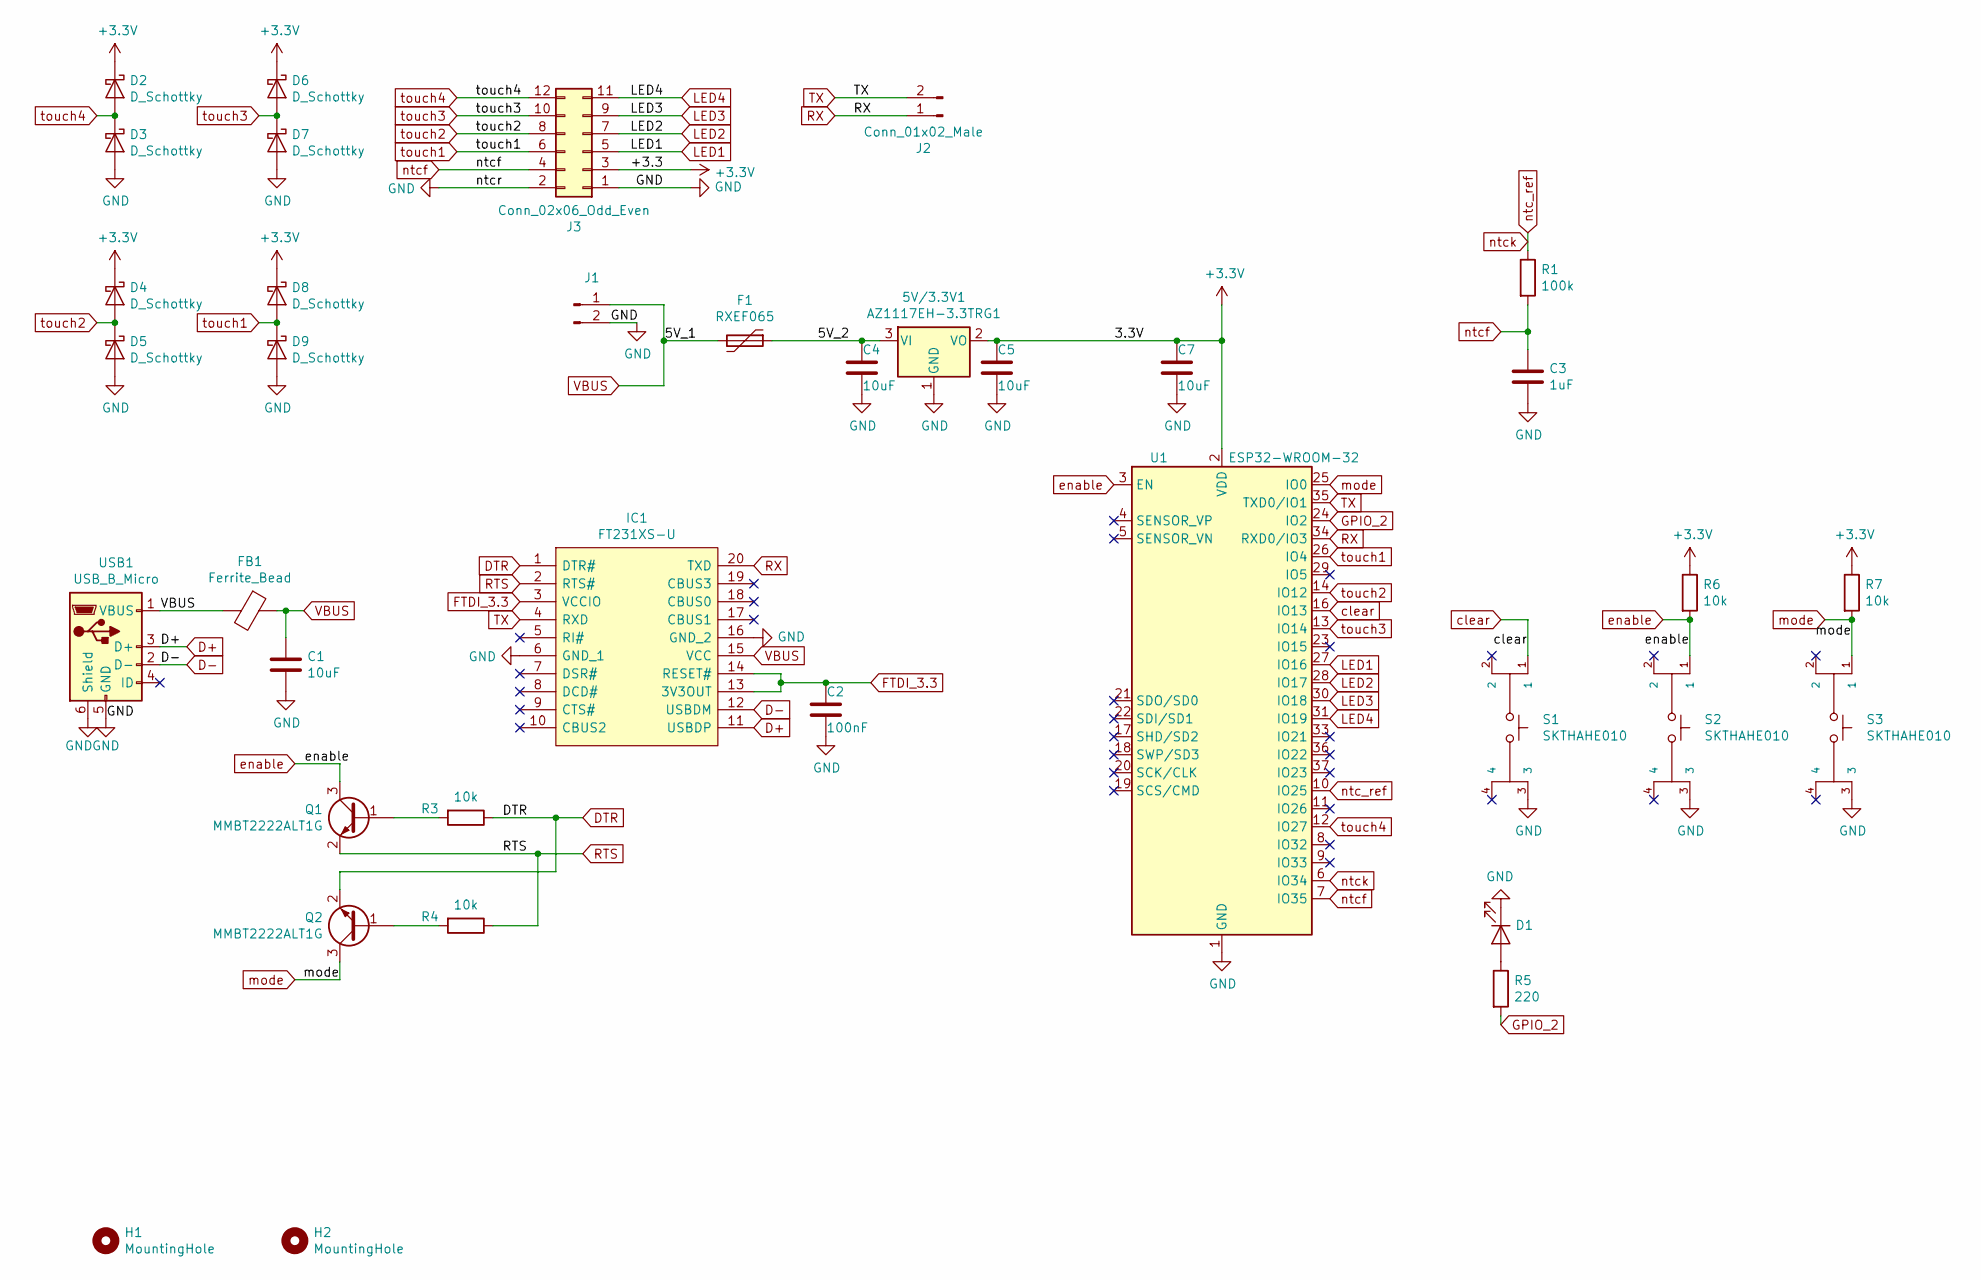
[picture p127: schematic Sensorbaustein.sch]

Parts:
5V/3.3V1: AZ1117EH-3.3TRG1; SOT-223-3_TabPin2
C1, C4, C5, C7: 10uF; C_0603_1608Metric_Pad1.05x0.95mm_HandSolder
C2: 100nF; C_0603_1608Metric_Pad1.05x0.95mm_HandSolder
C3: 1uF; C_0603_1608Metric_Pad1.05x0.95mm_HandSolder
D1: 150060BS55040; LED_0603_1608Metric_Pad1.05x0.95mm_HandSolder
D2, D3, D4, D5, D6, D7, D8, D9: D_Schottky; D_SOT-23_ANK
F1: RXEF065; RXEF050
FB1: Ferrite_Bead; R_0603_1608Metric_Pad1.05x0.95mm_HandSolder
H1, H2: MountingHole; MountingHole_3.2mm_M3_ISO14580
IC1: FT231XS-U; SOP64P599X175-20N; Manufacturer_Part_Number FT231XS-U; Mouser Part Number 895-FT231XS-U
J1, J2: Conn_01x02_Male; PinHeader_1x02_P2.54mm_Vertical
J3: Conn_02x06_Odd_Even; PinSocket_2x06_P2.54mm_Vertical
Q1, Q2: MMBT2222ALT1G; SOT-23
R1: 100k; R_0603_1608Metric_Pad1.05x0.95mm_HandSolder
R3, R4, R6, R7: 10k; R_0603_1608Metric_Pad1.05x0.95mm_HandSolder
R5: 220; R_0603_1608Metric_Pad1.05x0.95mm_HandSolder
S1, S2, S3: SKTHAHE010; SW_SKTHAHE010
U1: ESP32-WROOM-32
USB1: USB_B_Micro; USB_Micro-B_Wuerth_629105150521

Connections:
+3V3: 5V/3.3V1.2 (VO), C5.1, C7.1, D2.1 (K), D4.1 (K), D6.1 (K), D8.1 (K), J3.3, R6.1, R7.1, U1.2 (VDD)
/5V_2: 5V/3.3V1.3 (VI), C4.1, F1.1
D+: IC1.11 (USBDP), USB1.3 (D+)
D-: IC1.12 (USBDM), USB1.2 (D-)
DTR: IC1.1 (DTR#), Q2.2 (E), R3.1
FTDI_3.3: C2.1, IC1.3 (VCCIO), IC1.13 (3V3OUT), IC1.14 (RESET#)
GND: 5V/3.3V1.1 (GND), C1.2, C2.2, C3.2, C4.2, C5.2, C7.2, D1.1 (K), D3.2 (A), D5.2 (A), D7.2 (A), D9.2 (A), IC1.6 (GND_1), IC1.16 (GND_2), J1.2, J3.1, J3.2, S1.3, S2.3, S3.3, U1.1 (GND), U1.15 (GND), U1.38 (GND), USB1.5 (GND), USB1.6 (Shield)
GPIO_2: R5.2, U1.24 (IO2)
LED1: J3.5, U1.27 (IO16)
LED2: J3.7, U1.28 (IO17)
LED3: J3.9, U1.30 (IO18)
LED4: J3.11, U1.31 (IO19)
unnamed: D1.2 (A), R5.1
unnamed: Q1.1 (B), R3.2
unnamed: Q2.1 (B), R4.2
RTS: IC1.2 (RTS#), Q1.2 (E), R4.1
RX: IC1.20 (TXD), J2.1, U1.34 (RXD0/IO3)
TX: IC1.4 (RXD), J2.2, U1.35 (TXD0/IO1)
VBUS: C1.1, F1.2, FB1.1, FB1.2, IC1.15 (VCC), J1.1, USB1.1 (VBUS)
clear: S1.1, U1.16 (IO13)
enable: Q1.3 (C), R6.2, S2.1, U1.3 (EN)
mode: Q2.3 (C), R7.2, S3.1, U1.25 (IO0)
ntc_ref: R1.1, U1.6 (IO34), U1.10 (IO25)
ntcf: C3.1, J3.4, R1.2, U1.7 (IO35)
touch1: D8.2 (A), D9.1 (K), J3.6, U1.26 (IO4)
touch2: D4.2 (A), D5.1 (K), J3.8, U1.14 (IO12)
touch3: D6.2 (A), D7.1 (K), J3.10, U1.13 (IO14)
touch4: D2.2 (A), D3.1 (K), J3.12, U1.12 (IO27)

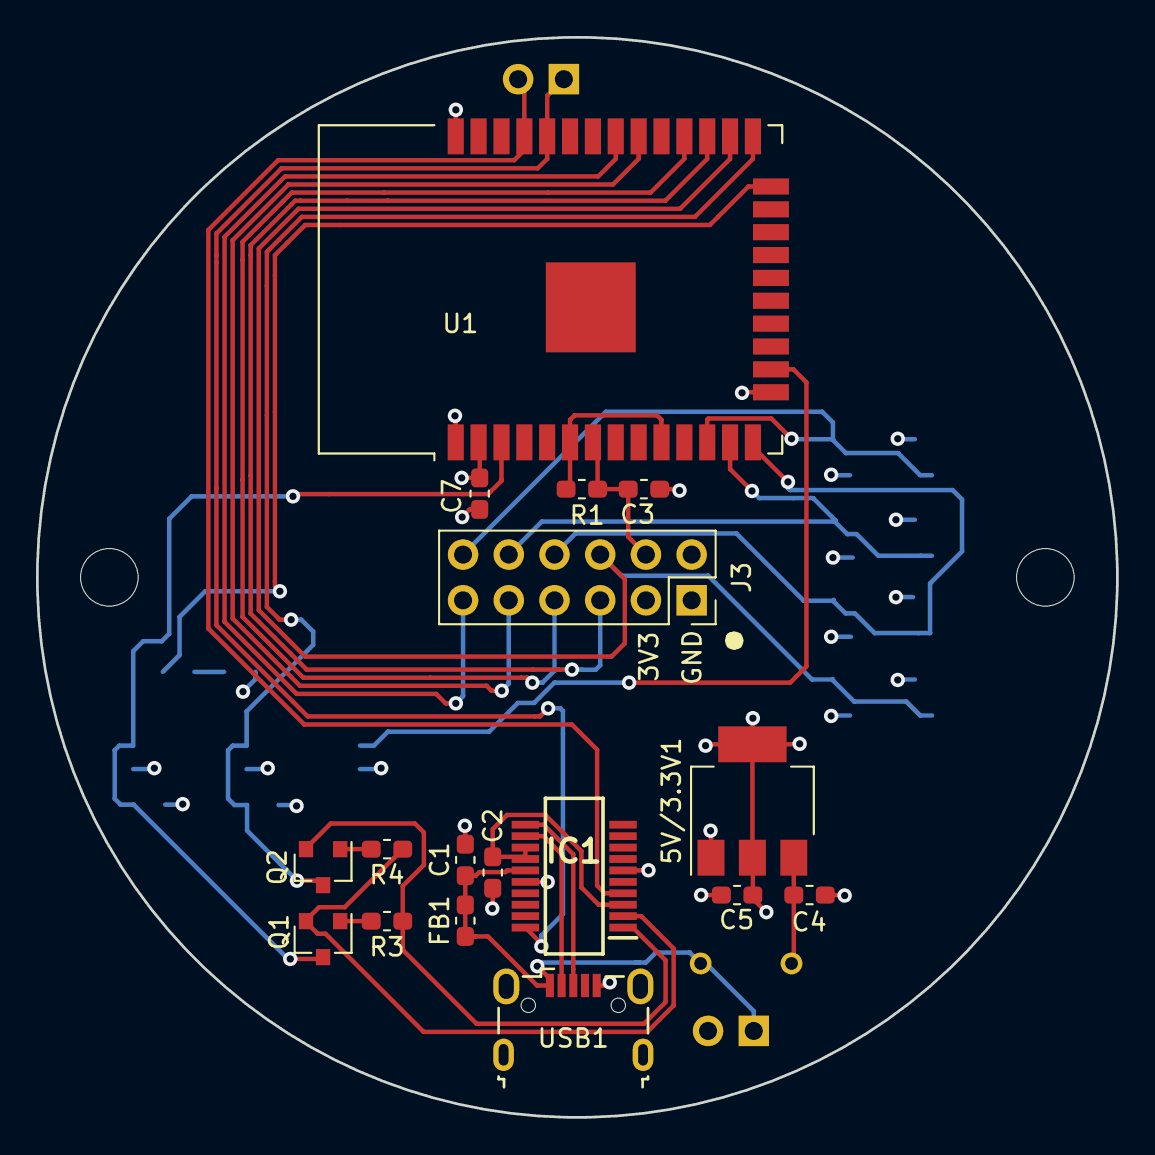
[picture p128: board Sensorbaustein.kicad_pcb from above]

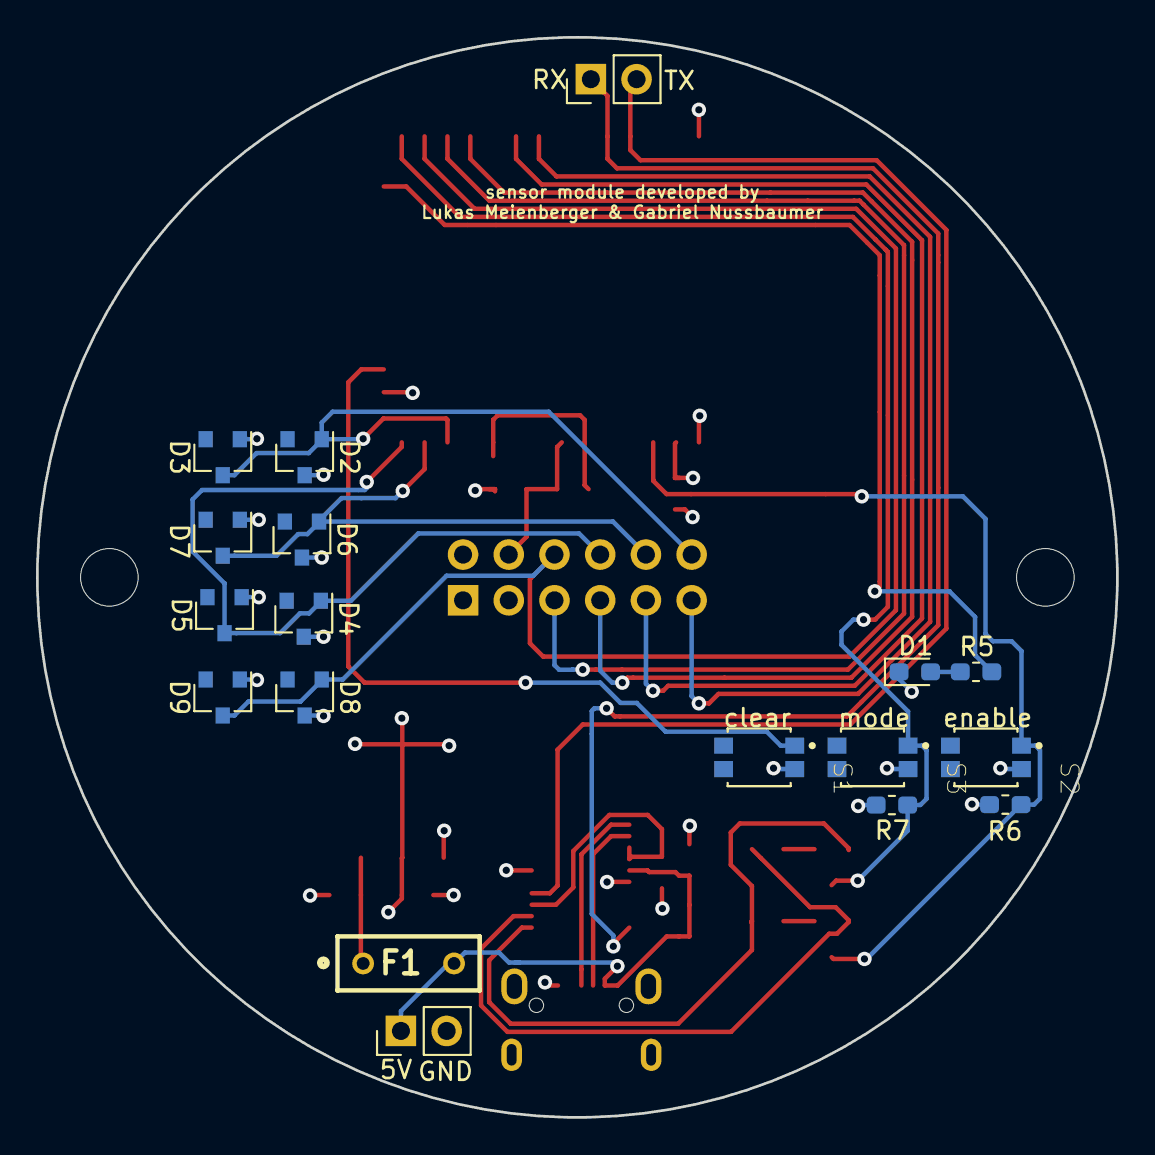
[picture p129: board Sensorbaustein.kicad_pcb from below]

Board: 4 copper layers, 60.0 x 60.0 mm, 37 parts (18 on the bottom side), 28 nets.
