nussinussi/Projekt6Thesis/Hardware/Frontplatte_v1.6/Frontplatte.kicad_pcb

## KiCad design Hardware/Frontplatte_v1.6/Frontplatte.kicad_pcb (2020-07-04)

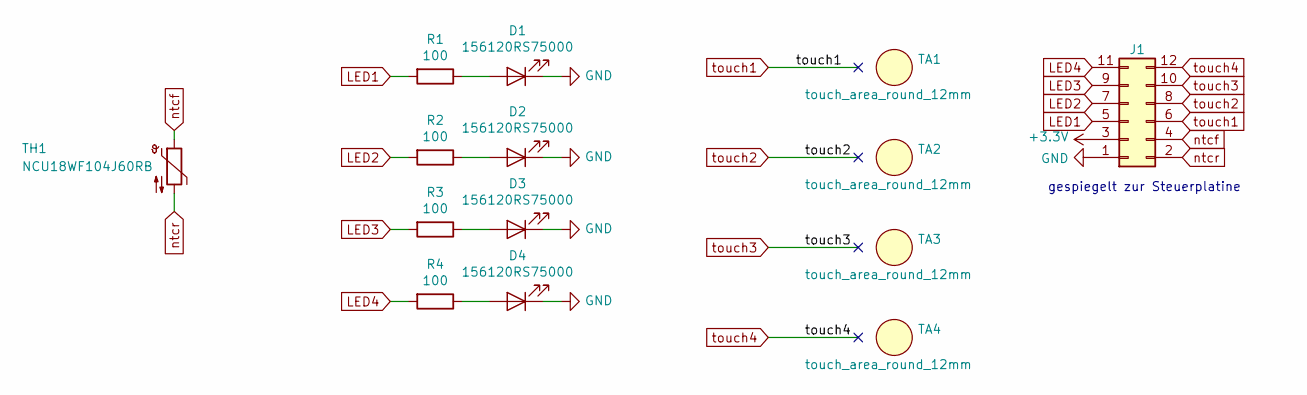
[picture p130: schematic Frontplatte.sch]

Parts:
D1, D2, D3, D4: 156120RS75000; reverse_mounted_LED_hole_2.3mm
J1: 61000621121; PinHeader_2x06_P2.54mm_Vertical_SMD; mouser 710-61000621121
R1, R2, R3, R4: 100; R_0603_1608Metric_Pad1.05x0.95mm_HandSolder
TA1, TA2, TA3, TA4: touch_area_round_12mm; touch_area
TH1: NCU18WF104J60RB; R_0603_1608Metric_Pad1.05x0.95mm_HandSolder

Connections:
+3V3: J1.3
GND: D1.1 (K), D2.1 (K), D3.1 (K), D4.1 (K), J1.1
LED1: J1.5, R1.2
LED2: J1.7, R2.2
LED3: J1.9, R3.2
LED4: J1.11, R4.2
unnamed: D1.2 (A), R1.1
unnamed: D2.2 (A), R2.1
unnamed: D3.2 (A), R3.1
unnamed: D4.2 (A), R4.1
ntcf: J1.4, TH1.1
ntcr: J1.2, TH1.2
touch1: J1.6
touch2: J1.8
touch3: J1.10
touch4: J1.12

Notes on the sheet:
gespiegelt zur Steuerplatine

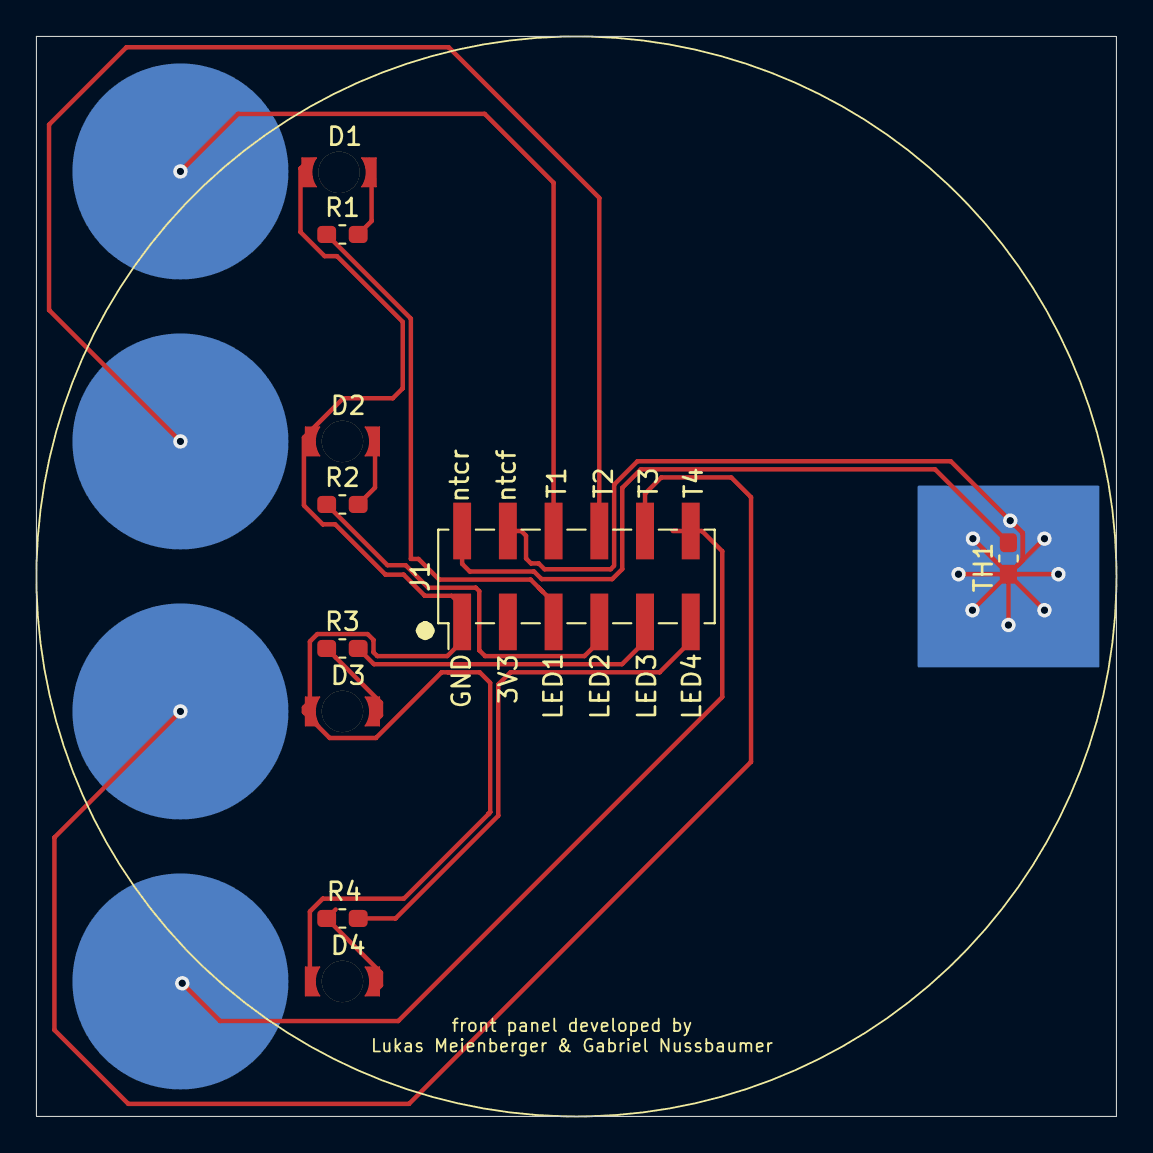
[picture p131: board Frontplatte.kicad_pcb from above]

Board: 2 copper layers, 60.0 x 60.0 mm, 14 parts (0 on the bottom side), 11 nets.
