nussinussi/Projekt6Thesis/Software/Version 1 Home Assistant/config-configuration.yaml.txt

# Configure a default setup of Home Assistant (frontend, api, etc)
default_config:

# Text to speech
tts:
  - platform: google_translate

# Example configuration.yaml entry to enable the cloud component
cloud:

group: !include groups.yaml
automation: !include automations.yaml
script: !include scripts.yaml
scene: !include scenes.yaml

mqtt:
  broker: 192.168.137.8
  port: 1883

# Example configuration.yaml entry
switch:
  - platform: mqtt
    name: Licht Wohnzimmer
    command_topic: "data/sensorboard/homeassisant/S1"
    icon: mdi:lightbulb

  - platform: mqtt
    name: Licht Esszimmer
    command_topic: "data/sensorboard/homeassisant/S2"
    icon: mdi:lightbulb
    
  - platform: mqtt
    name: Licht Büro
    command_topic: "data/sensorboard/homeassisant/S3"
    icon: mdi:lightbulb
    

  - platform: mqtt
    name: Licht Aussen
    command_topic: "data/sensorboard/homeassisant/S4"
    icon: mdi:lightbulb
