nussinussi/Projekt6Thesis/(commit log)

2020-07-09 Software stand 09.07.2020
    [addons.cfg, dashboard.cfg, runtime.cfg]
2020-07-15 ESP aktorboard
    [addons.cfg, dashboard.cfg, runtime.cfg]
2020-08-03 Fachbericht Software Sensorboard
2020-08-04 doku sensor software
2020-08-04 doku software sensor
2020-08-10 Benutzerhanbuch OH
    [addons.cfg, dashboard.cfg, openhabcloud.cfg, runtime.cfg]
2020-08-11 Anpassung Software Versionen
    [addons.cfg, config-configuration.yaml.txt, dashboard.cfg, openhabcloud.cfg, runtime.cfg]
